eddiemoroz/Automated-9MM-Brass-Headstamp-Sorting-System/ESP32 Code/Arduino IDE Settings.txt

Version 2.3.7

BOARDS MANAGER: INSTALL esp32

Tools->
-
Board: "ESP32S3 Dev Module"
-
USB CDC On Boot: "Enabled"
CPU Frequency: "240MHz (Wifi)"
Core Debug Level: "None"
USB DFU On Boot: "Diabled"
Erase All Flash Before Sketch Upload: "Enabled"
Events Run On: "Core 1"
Flash Mode: "QIO 80MHz"
Flash Size: "4MB (32Mb)"
JTAG Adapter: "Disabled"
Arduino Runs On: "Core 1"
USB Firmware MSC On Boot: "Disabled"
Partition Scheme: "Default 4MB with spiffs (1.2MB APP/1.5MB SPIFFS)"
PSRAM: "Disabled"
Upload Mode: "UART0/Hardware CDC"
Upload Speed: "921600"
USB Mode: "Hardware CDC and JTAG"
Zigbee Mode: "Disabled"
-
Programmer: "Esptool"
