eddiemoroz/Automated-9MM-Brass-Headstamp-Sorting-System/Enclosure/Bins/Bin Base R.stl

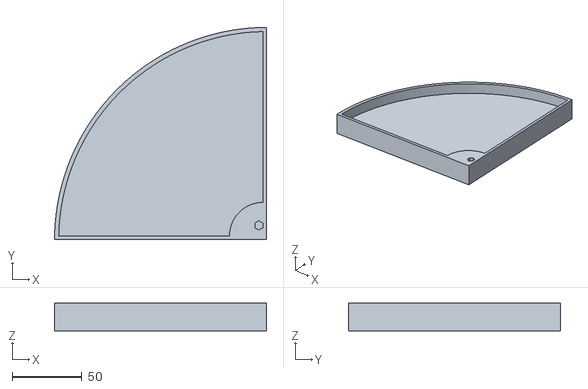
[picture p1: CAD file, 2026-05-16]
Enclosure/Bins/Bin Base R.stl
151.9 x 152.1 x 20.0
