eddiemoroz/Automated-9MM-Brass-Headstamp-Sorting-System/Enclosure/Camera/Camera Mount Column.stl

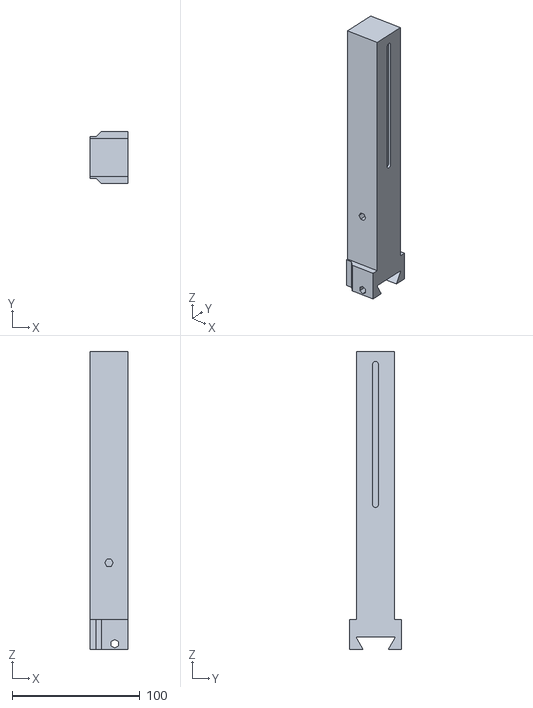
[picture p2: CAD file, 2026-05-16]
Enclosure/Camera/Camera Mount Column.stl
30.0 x 40.8 x 233.6
