eddiemoroz/Automated-9MM-Brass-Headstamp-Sorting-System/Enclosure/Display/Display Mount.stl

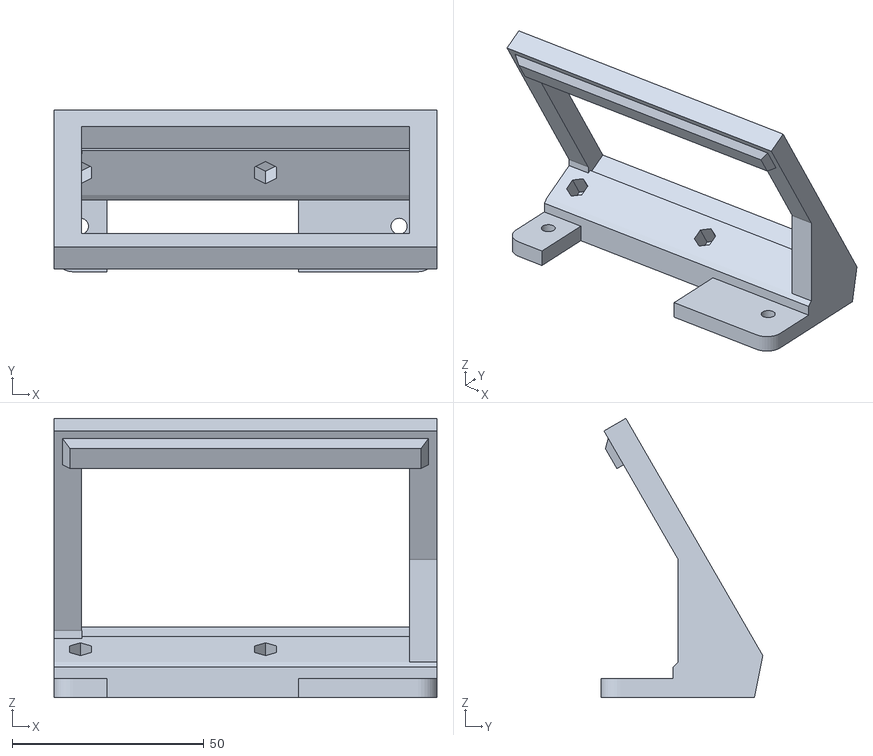
[picture p3: CAD file, 2026-05-16]
Enclosure/Display/Display Mount.stl
100.0 x 42.2 x 72.9
