eddiemoroz/Automated-9MM-Brass-Headstamp-Sorting-System/Enclosure/Feeding Tube/Feeding Tube Adjustment.stl

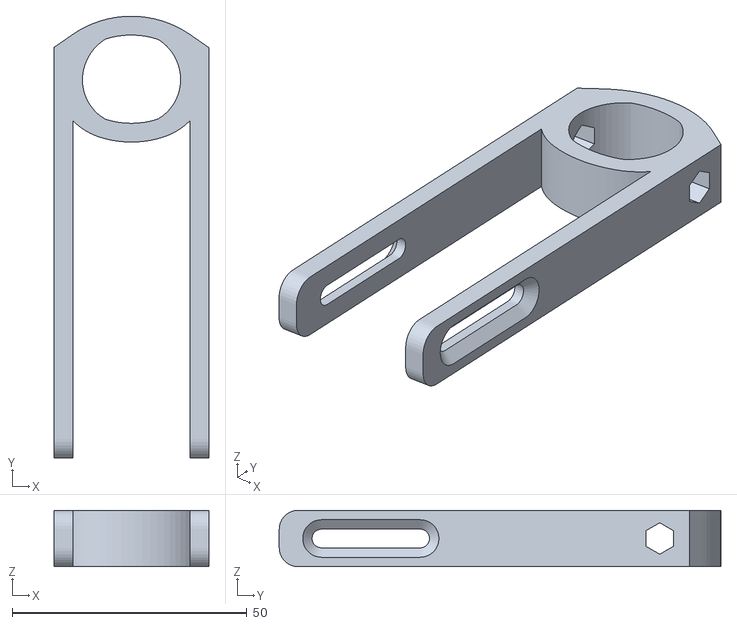
[picture p4: CAD file, 2026-05-16]
Enclosure/Feeding Tube/Feeding Tube Adjustment.stl
33.0 x 94.0 x 12.0
