eddiemoroz/Automated-9MM-Brass-Headstamp-Sorting-System/Enclosure/Frame/Camera Pillar.stl

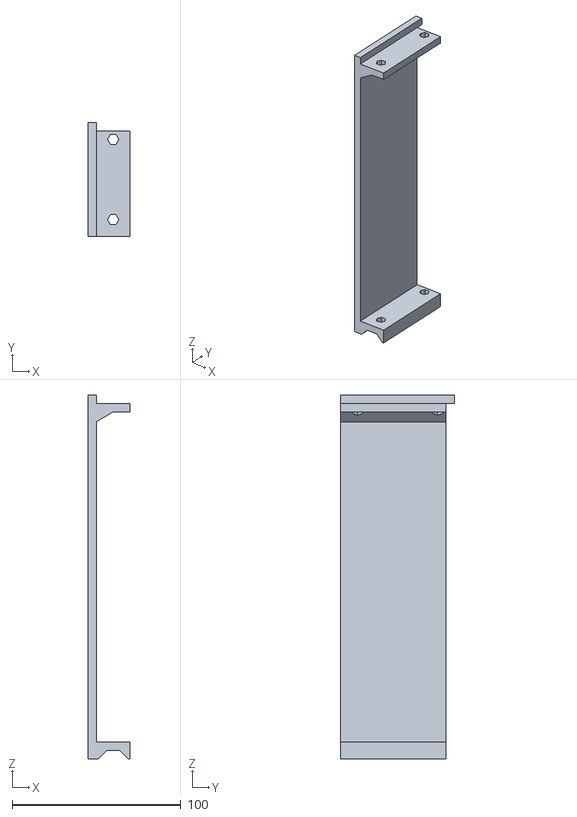
[picture p5: CAD file, 2026-05-16]
Enclosure/Frame/Camera Pillar.stl
25.0 x 67.6 x 215.9
