eddiemoroz/Automated-9MM-Brass-Headstamp-Sorting-System/Enclosure/Frame/Floor Supports/Floor Support L.stl

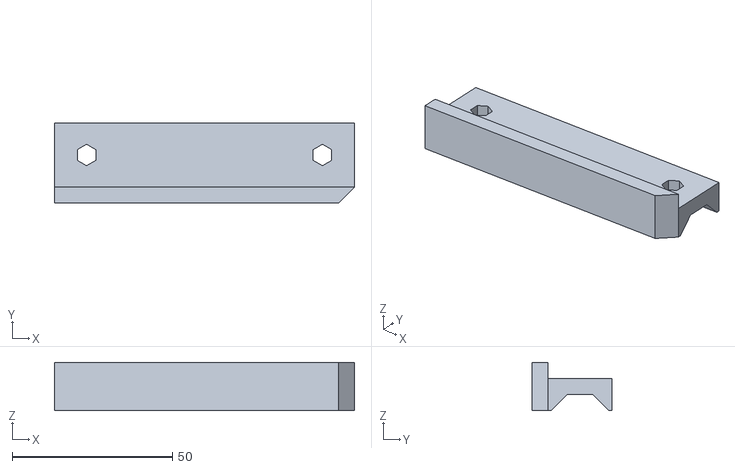
[picture p6: CAD file, 2026-05-16]
Enclosure/Frame/Floor Supports/Floor Support L.stl
93.6 x 25.0 x 15.0
