eddiemoroz/Automated-9MM-Brass-Headstamp-Sorting-System/Enclosure/Shroud/Shroud L.stl

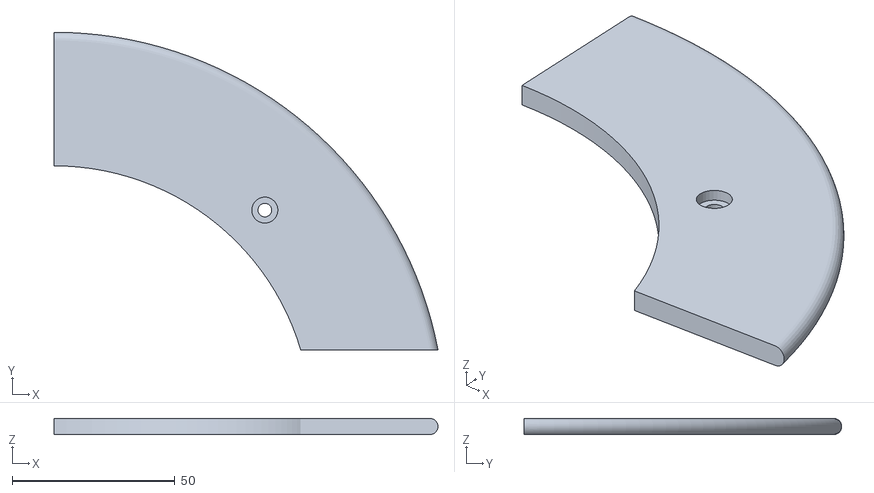
[picture p7: CAD file, 2026-05-16]
Enclosure/Shroud/Shroud L.stl
117.9 x 97.5 x 5.00
