eddiemoroz/Automated-9MM-Brass-Headstamp-Sorting-System/Enclosure/Sorter.stl

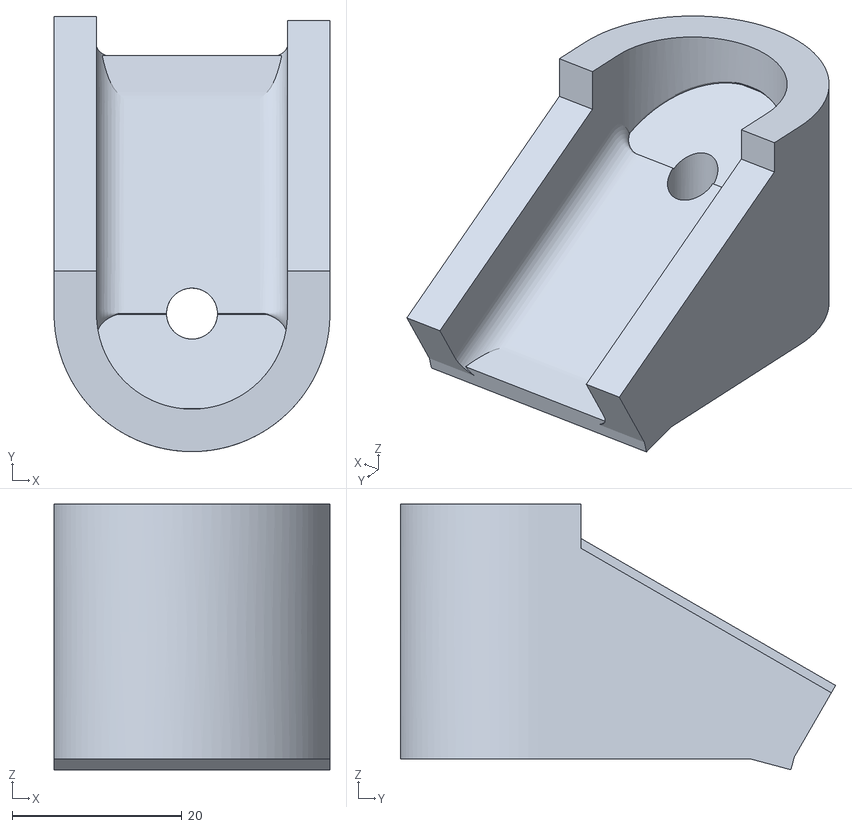
[picture p8: CAD file, 2026-05-16]
Enclosure/Sorter.stl
32.5 x 51.2 x 31.3
