eddiemoroz/Automated-9MM-Brass-Headstamp-Sorting-System/Enclosure/Bins/Bin1.stl

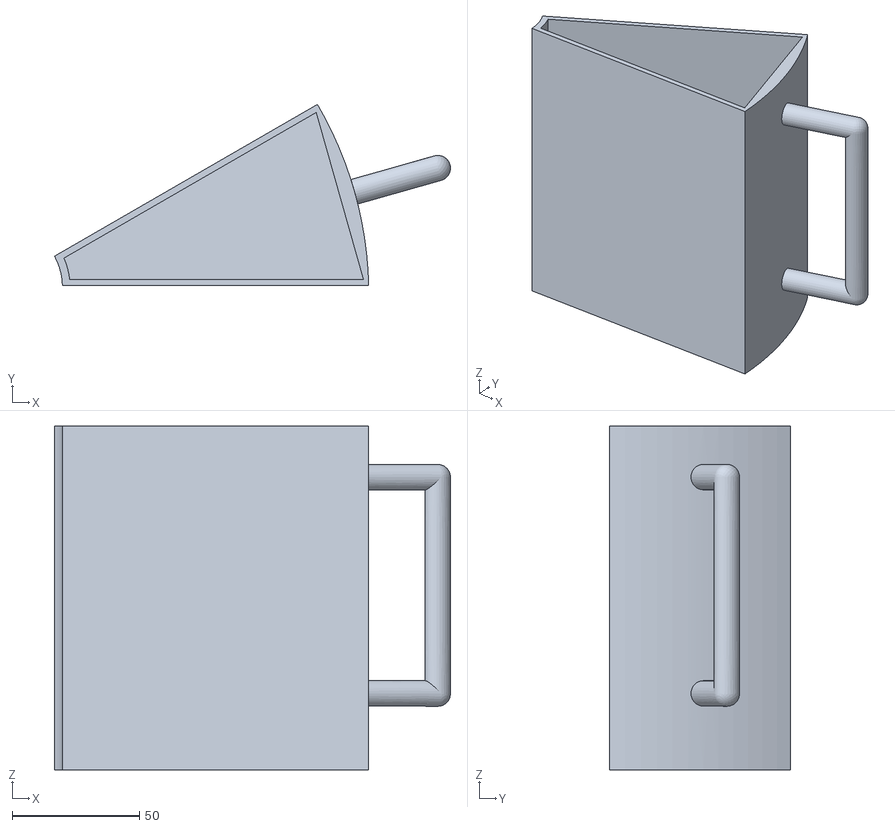
[picture p9: CAD file, 2026-05-16]
Enclosure/Bins/Bin1.stl
155.6 x 71.2 x 135.0
