eddiemoroz/Automated-9MM-Brass-Headstamp-Sorting-System/Enclosure/Camera/Camera Mount Base.stl

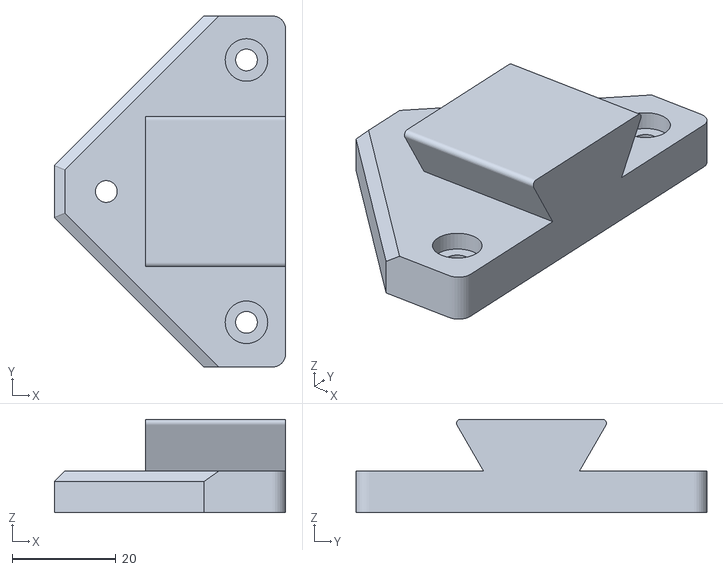
[picture p10: CAD file, 2026-05-16]
Enclosure/Camera/Camera Mount Base.stl
44.5 x 67.6 x 18.0
