eddiemoroz/Automated-9MM-Brass-Headstamp-Sorting-System/Enclosure/Display/Display Mount Clamp.stl

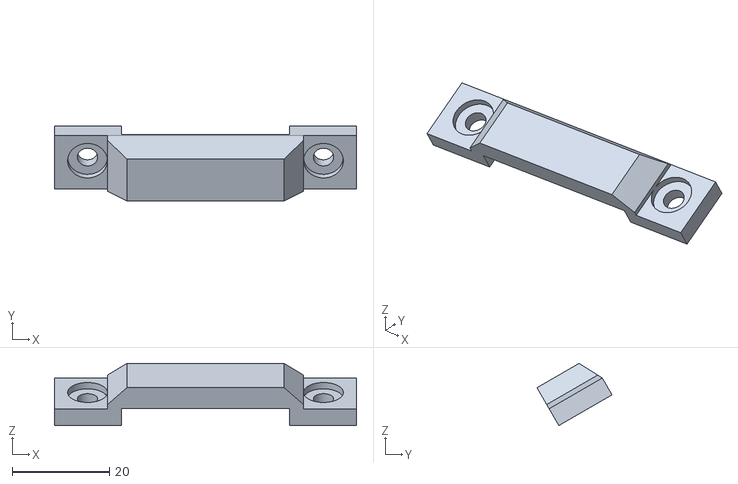
[picture p11: CAD file, 2026-05-16]
Enclosure/Display/Display Mount Clamp.stl
62.2 x 15.5 x 12.8
