eddiemoroz/Automated-9MM-Brass-Headstamp-Sorting-System/Enclosure/Feeding Tube/Feeding Tube Base.stl

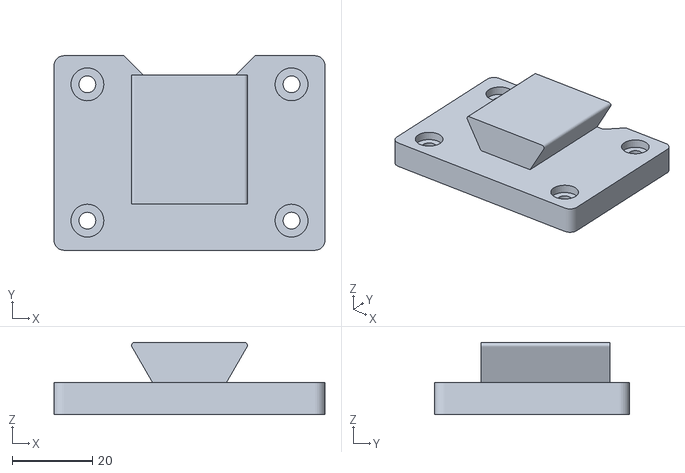
[picture p12: CAD file, 2026-05-16]
Enclosure/Feeding Tube/Feeding Tube Base.stl
67.6 x 48.5 x 18.0
