eddiemoroz/Automated-9MM-Brass-Headstamp-Sorting-System/Enclosure/Frame/Floor Supports/Floor Support M.stl

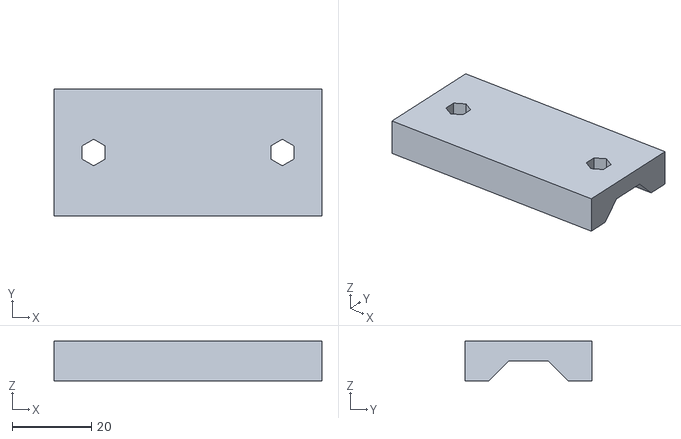
[picture p13: CAD file, 2026-05-16]
Enclosure/Frame/Floor Supports/Floor Support M.stl
67.6 x 32.0 x 10.00
