eddiemoroz/Automated-9MM-Brass-Headstamp-Sorting-System/Enclosure/Frame/Rear Pillar.stl

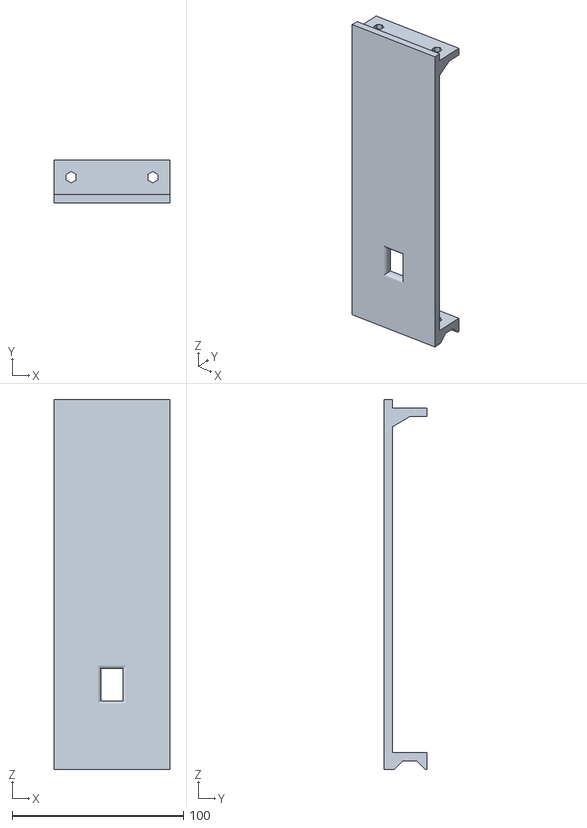
[picture p14: CAD file, 2026-05-16]
Enclosure/Frame/Rear Pillar.stl
67.6 x 25.0 x 215.9
