eddiemoroz/Automated-9MM-Brass-Headstamp-Sorting-System/Enclosure/Revolver.stl

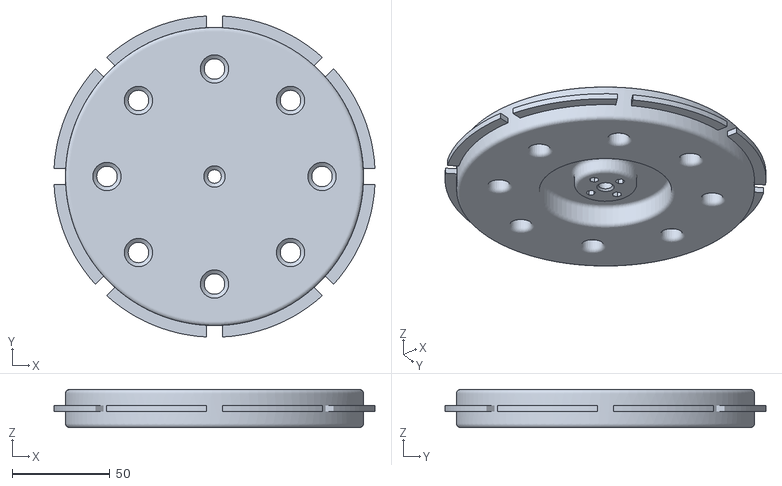
[picture p15: CAD file, 2026-05-16]
Enclosure/Revolver.stl
164.2 x 164.2 x 19.5
