eddiemoroz/Automated-9MM-Brass-Headstamp-Sorting-System/Enclosure/Camera/Camera Holder.stl

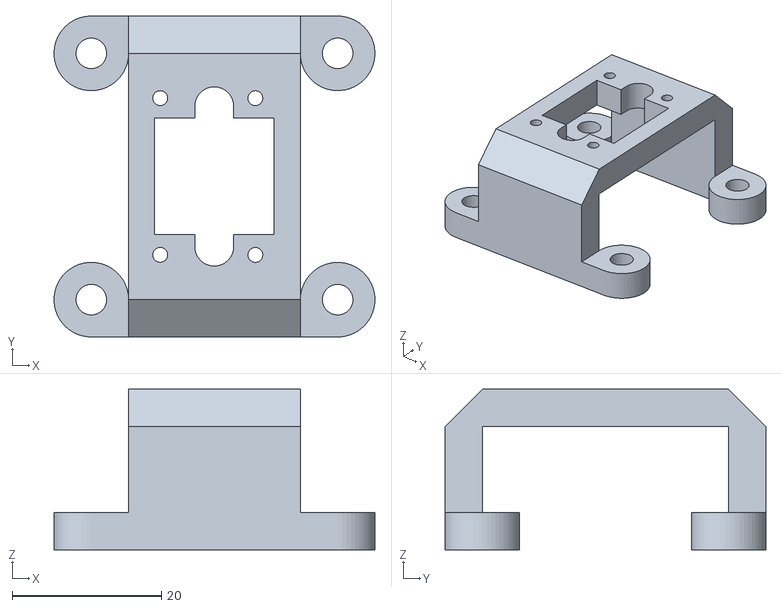
[picture p16: CAD file, 2026-05-16]
Enclosure/Camera/Camera Holder.stl
43.0 x 43.0 x 21.5
