eddiemoroz/Automated-9MM-Brass-Headstamp-Sorting-System/Enclosure/Display/Display Base.stl

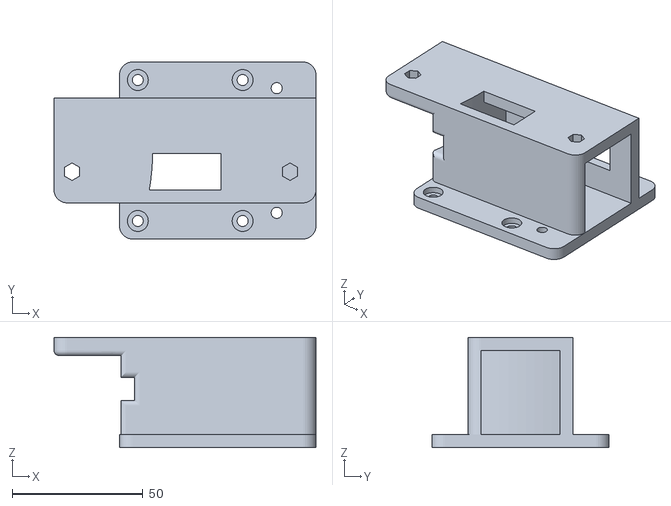
[picture p17: CAD file, 2026-05-16]
Enclosure/Display/Display Base.stl
100.0 x 67.6 x 42.1
