eddiemoroz/Automated-9MM-Brass-Headstamp-Sorting-System/Enclosure/Feeding Tube/Feed Tube Column.stl

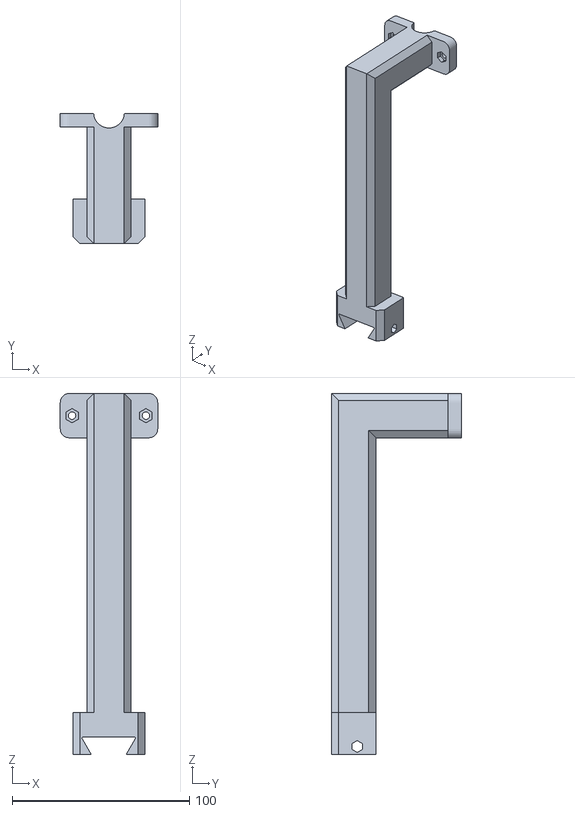
[picture p18: CAD file, 2026-05-16]
Enclosure/Feeding Tube/Feed Tube Column.stl
55.0 x 73.3 x 203.6
