eddiemoroz/Automated-9MM-Brass-Headstamp-Sorting-System/Enclosure/Frame/Floor Supports/Floor Support Ext R.stl

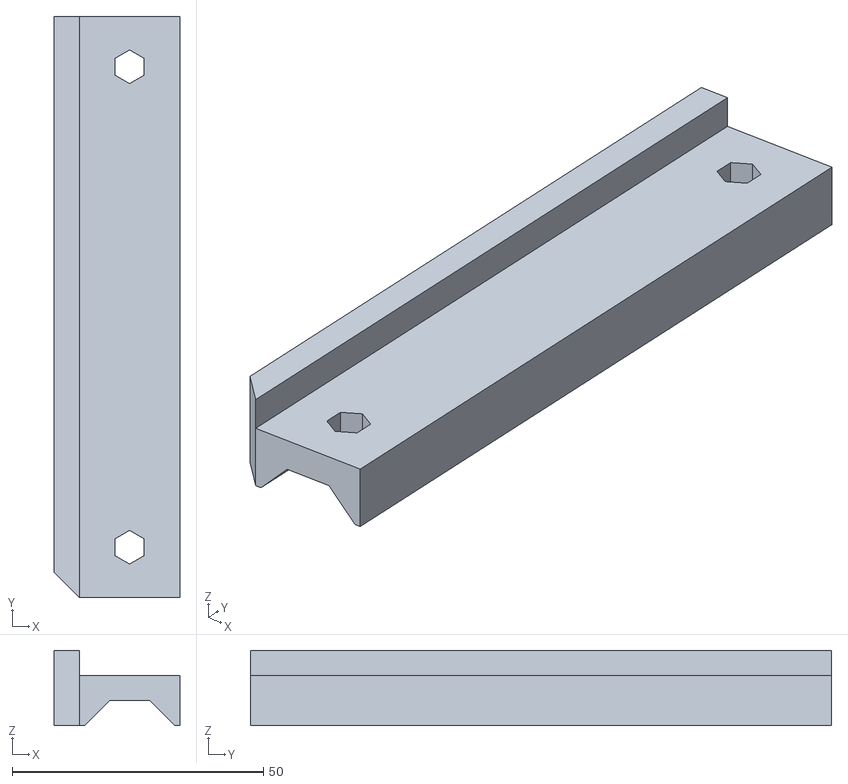
[picture p19: CAD file, 2026-05-16]
Enclosure/Frame/Floor Supports/Floor Support Ext R.stl
25.0 x 115.6 x 15.0
