eddiemoroz/Automated-9MM-Brass-Headstamp-Sorting-System/Enclosure/Frame/Servo Mount.stl

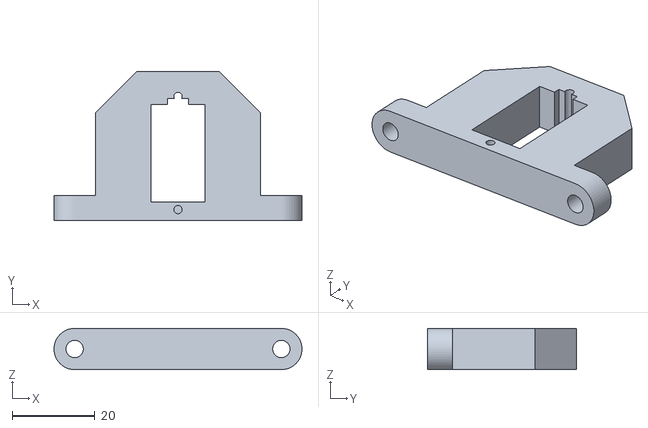
[picture p20: CAD file, 2026-05-16]
Enclosure/Frame/Servo Mount.stl
60.0 x 36.0 x 10.0
