eddiemoroz/Automated-9MM-Brass-Headstamp-Sorting-System/Enclosure/Photo Sensor Mount.stl

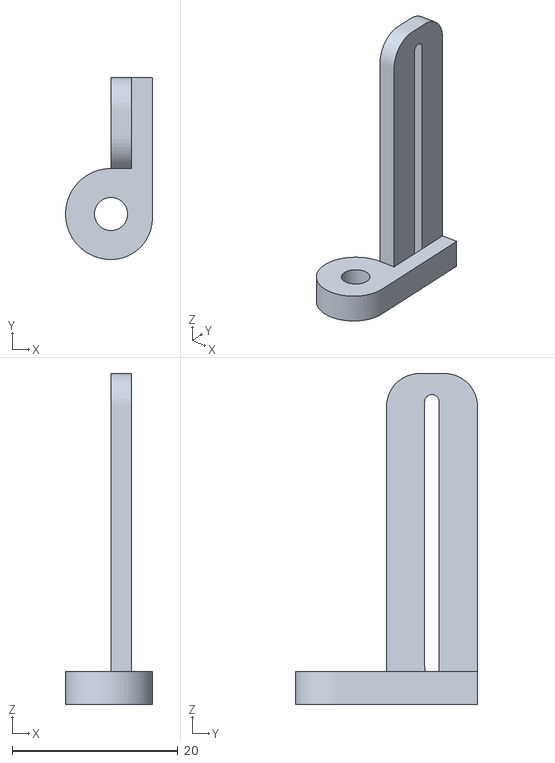
[picture p21: CAD file, 2026-05-16]
Enclosure/Photo Sensor Mount.stl
10.5 x 22.0 x 40.0
