eddiemoroz/Automated-9MM-Brass-Headstamp-Sorting-System/Enclosure/Shroud/Shroud connector.stl

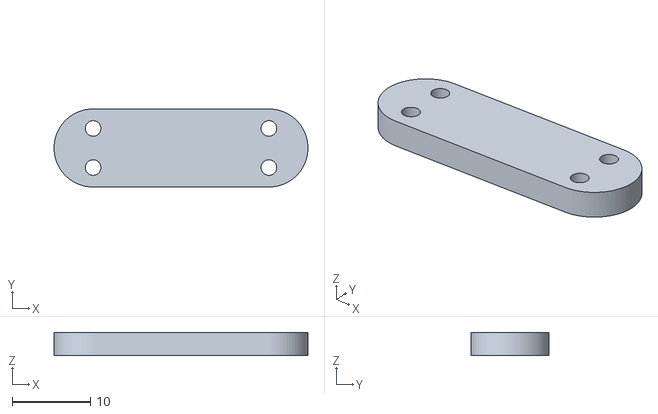
[picture p22: CAD file, 2026-05-16]
Enclosure/Shroud/Shroud connector.stl
32.5 x 10.0 x 3.00
