eddiemoroz/Automated-9MM-Brass-Headstamp-Sorting-System/Enclosure/Bins/Chicken Clamp.stl

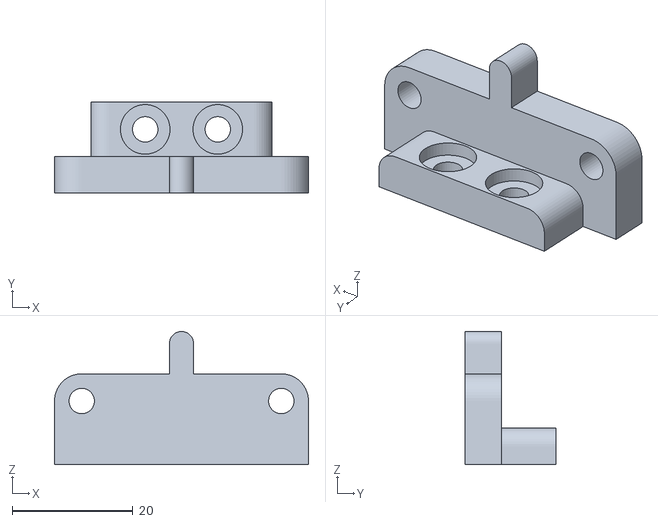
[picture p23: CAD file, 2026-05-16]
Enclosure/Bins/Chicken Clamp.stl
42.0 x 15.0 x 22.0
