eddiemoroz/Automated-9MM-Brass-Headstamp-Sorting-System/Enclosure/Camera/Bottom Funnel.stl

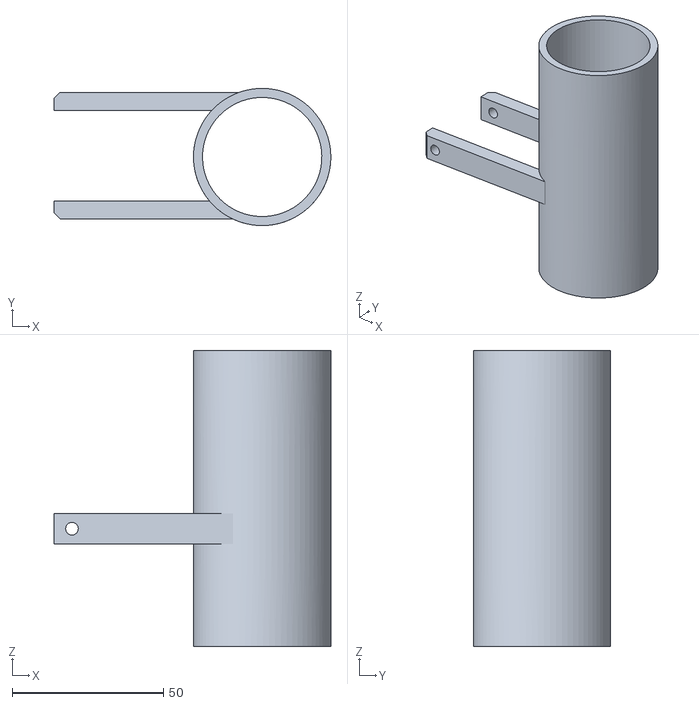
[picture p24: CAD file, 2026-05-16]
Enclosure/Camera/Bottom Funnel.stl
91.6 x 45.4 x 98.0
