eddiemoroz/Automated-9MM-Brass-Headstamp-Sorting-System/Enclosure/Feeding Tube/Feeding Tube Clamp.stl

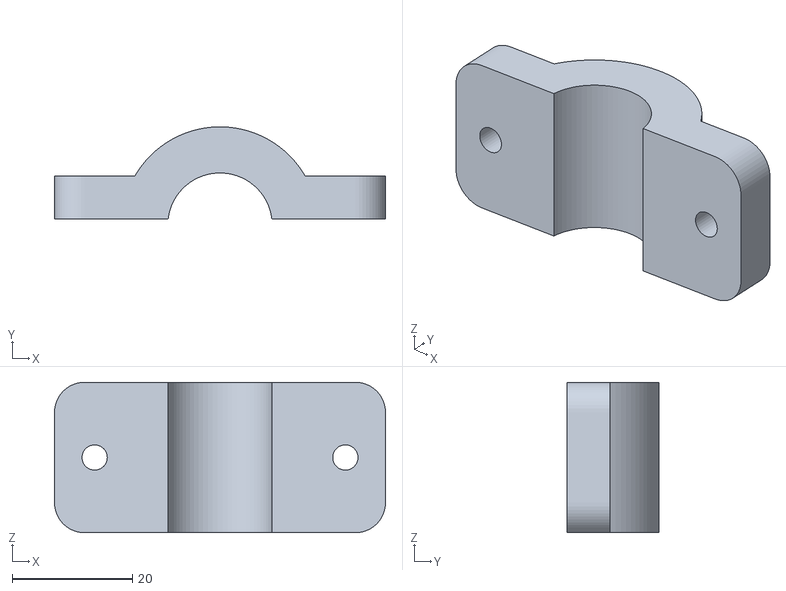
[picture p25: CAD file, 2026-05-16]
Enclosure/Feeding Tube/Feeding Tube Clamp.stl
55.0 x 15.3 x 25.0
