eddiemoroz/Automated-9MM-Brass-Headstamp-Sorting-System/Enclosure/Frame/Front Pillar.stl

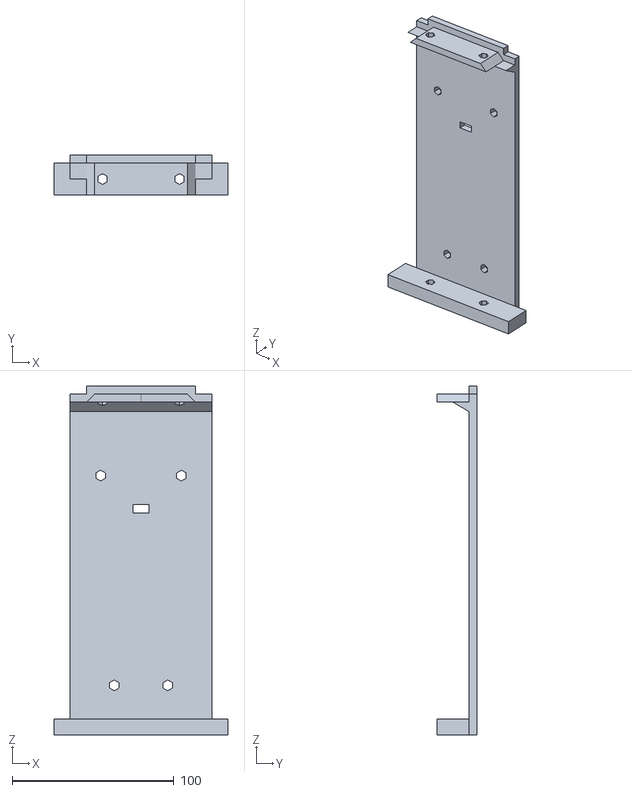
[picture p26: CAD file, 2026-05-16]
Enclosure/Frame/Front Pillar.stl
107.6 x 25.0 x 215.9
