eddiemoroz/Automated-9MM-Brass-Headstamp-Sorting-System/Enclosure/PCB Standoffs.stl

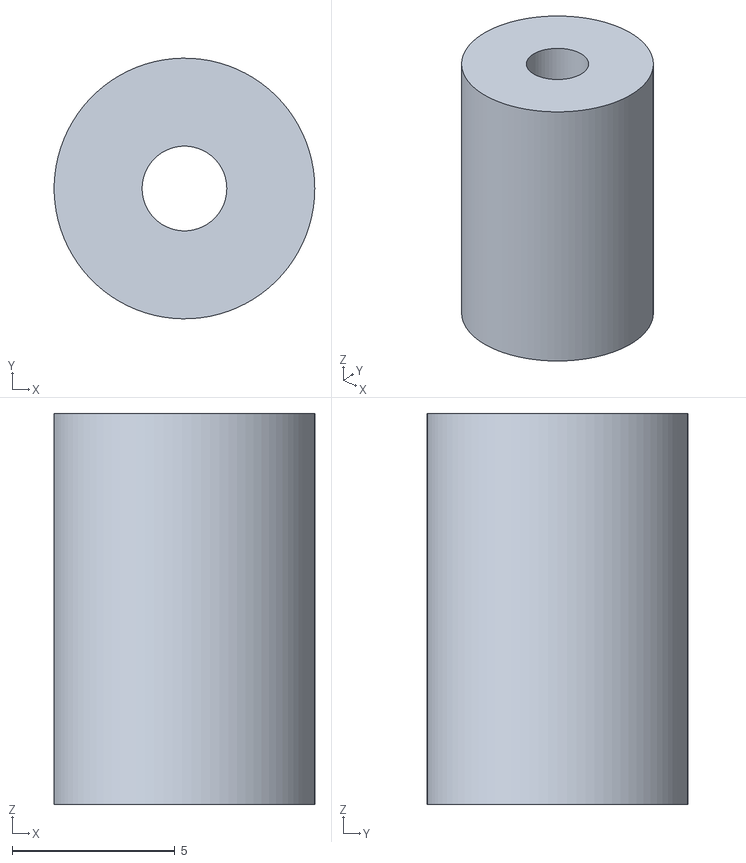
[picture p27: CAD file, 2026-05-16]
Enclosure/PCB Standoffs.stl
8.00 x 8.00 x 12.0
