eddiemoroz/Automated-9MM-Brass-Headstamp-Sorting-System/Enclosure/Shroud/Shroud Base.stl

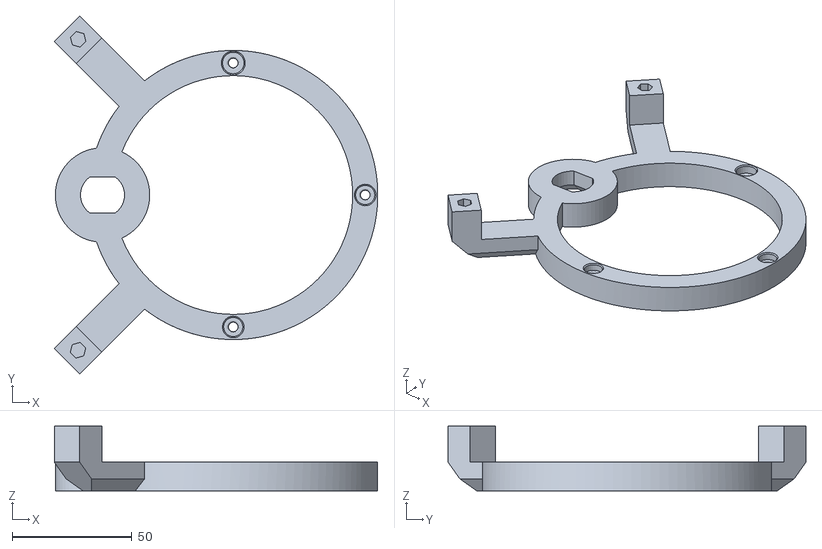
[picture p28: CAD file, 2026-05-16]
Enclosure/Shroud/Shroud Base.stl
134.8 x 149.2 x 27.0
