eddiemoroz/Automated-9MM-Brass-Headstamp-Sorting-System/Enclosure/Camera/Ring Light.stl

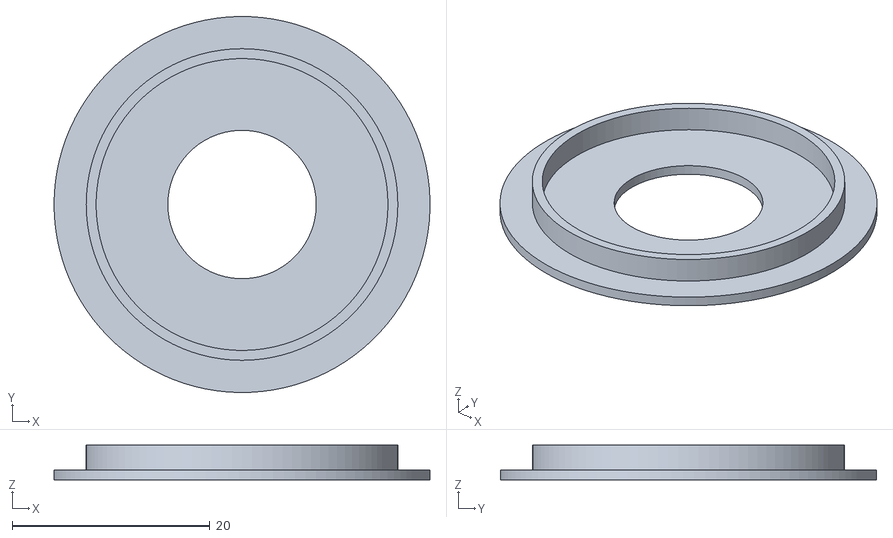
[picture p29: CAD file, 2026-05-16]
Enclosure/Camera/Ring Light.stl
38.0 x 38.0 x 3.50
