eddiemoroz/Automated-9MM-Brass-Headstamp-Sorting-System/Enclosure/Feeding Tube/Feeding Tube.stl

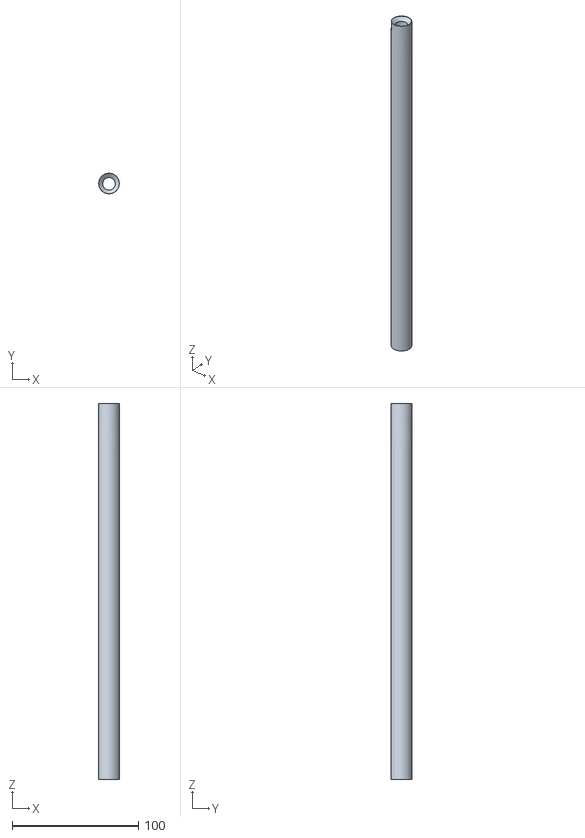
[picture p30: CAD file, 2026-05-16]
Enclosure/Feeding Tube/Feeding Tube.stl
16.3 x 16.4 x 298.0
