eddiemoroz/Automated-9MM-Brass-Headstamp-Sorting-System/Enclosure/Frame/Camera Face.stl

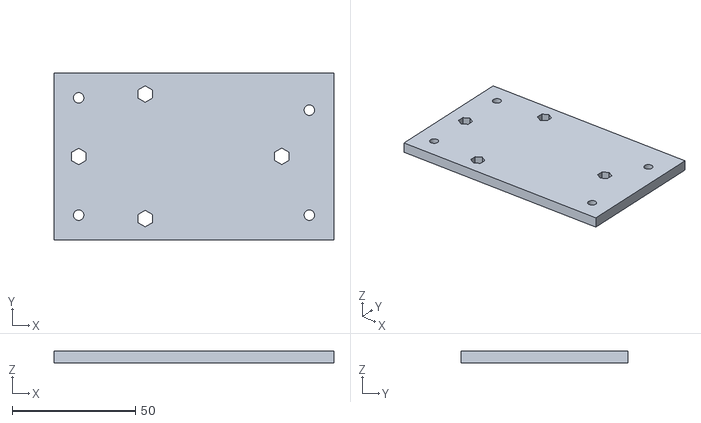
[picture p31: CAD file, 2026-05-16]
Enclosure/Frame/Camera Face.stl
113.6 x 67.6 x 5.00
