eddiemoroz/Automated-9MM-Brass-Headstamp-Sorting-System/Enclosure/Camera/Top Funnel.stl

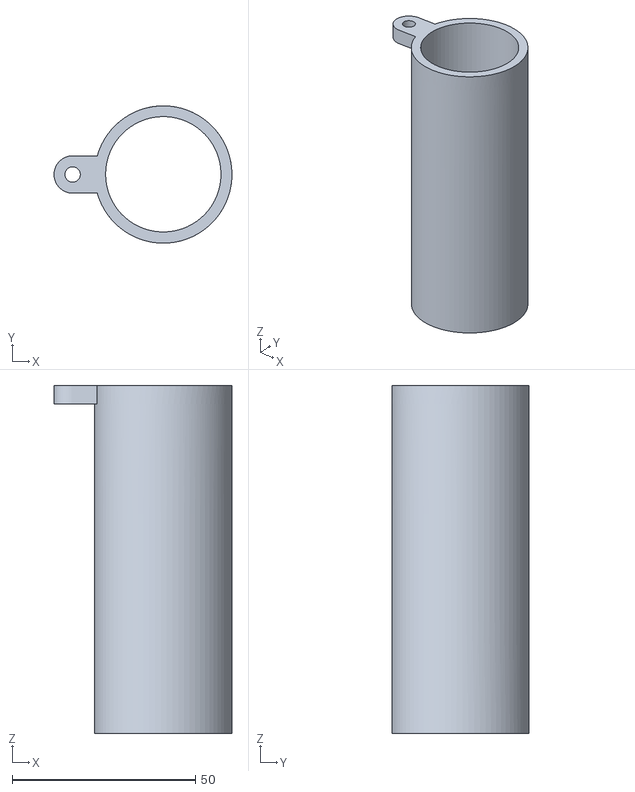
[picture p32: CAD file, 2026-05-16]
Enclosure/Camera/Top Funnel.stl
48.6 x 37.5 x 95.0
