eddiemoroz/Automated-9MM-Brass-Headstamp-Sorting-System/Enclosure/Frame/Bottom Panel R.stl

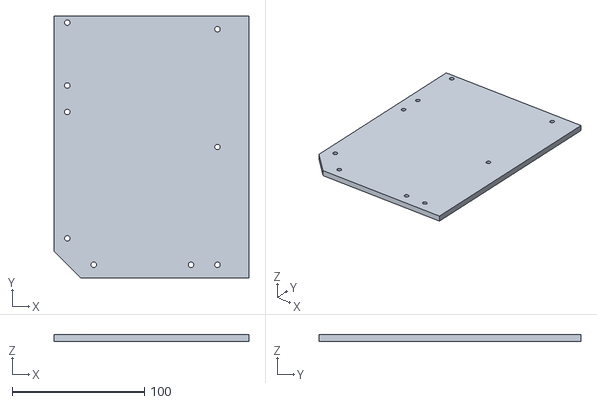
[picture p33: CAD file, 2026-05-16]
Enclosure/Frame/Bottom Panel R.stl
147.4 x 198.2 x 5.00
