eddiemoroz/Automated-9MM-Brass-Headstamp-Sorting-System/Enclosure/Camera/Camera Mount.stl

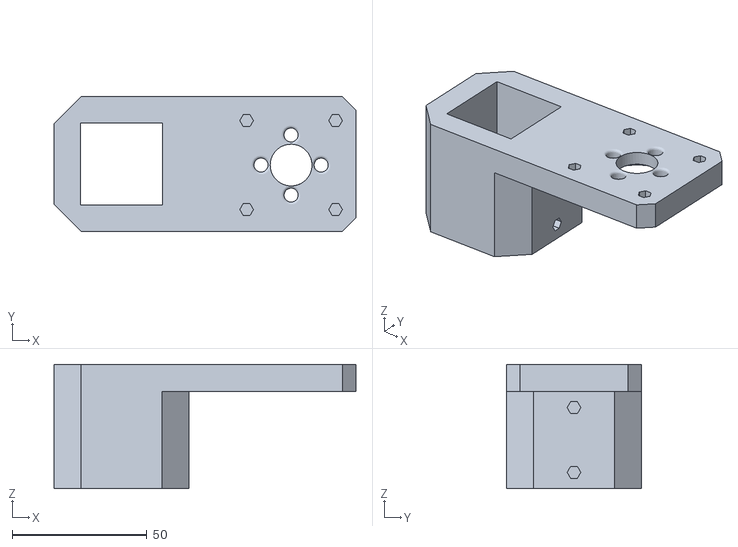
[picture p34: CAD file, 2026-05-16]
Enclosure/Camera/Camera Mount.stl
112.0 x 50.0 x 46.0
