eddiemoroz/Automated-9MM-Brass-Headstamp-Sorting-System/Enclosure/Frame/Top Face.stl

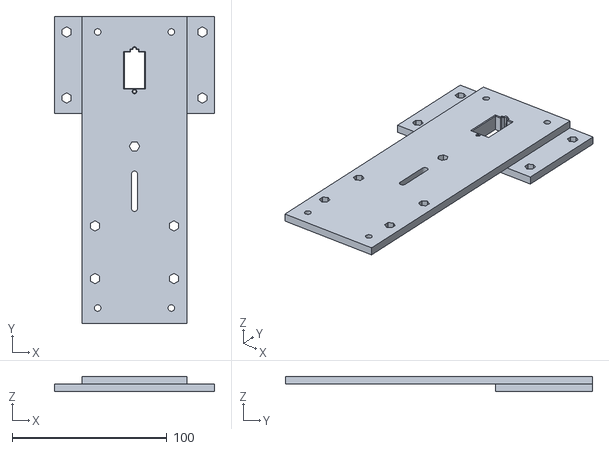
[picture p35: CAD file, 2026-05-16]
Enclosure/Frame/Top Face.stl
103.6 x 198.2 x 10.0
