eddiemoroz/Automated-9MM-Brass-Headstamp-Sorting-System/Enclosure/Frame/Bottom Panel L.stl

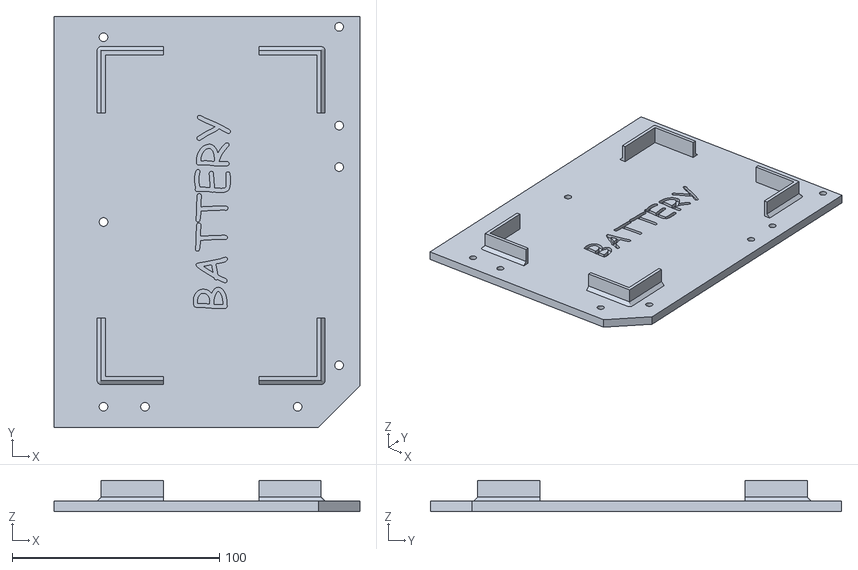
[picture p36: CAD file, 2026-05-16]
Enclosure/Frame/Bottom Panel L.stl
147.4 x 198.2 x 15.0
