eddiemoroz/Automated-9MM-Brass-Headstamp-Sorting-System/Enclosure/Frame/Left Panel.stl

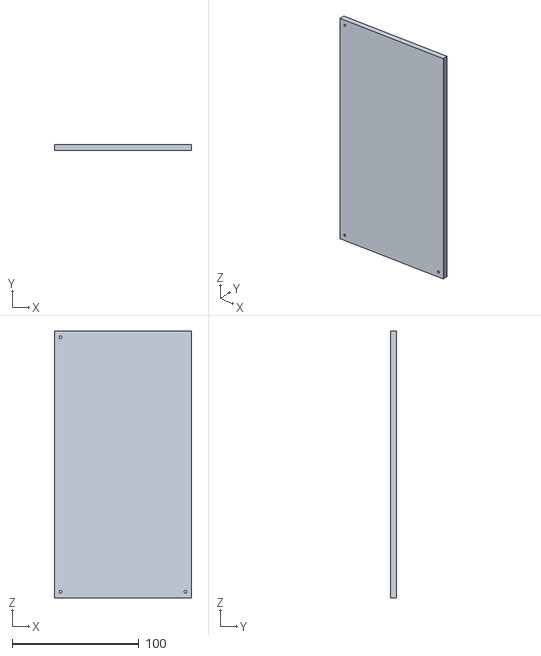
[picture p37: CAD file, 2026-05-16]
Enclosure/Frame/Left Panel.stl
108.6 x 5.00 x 210.9
