eddiemoroz/Automated-9MM-Brass-Headstamp-Sorting-System/(list of files, cad)

Other CAD files:
Enclosure/Shroud/Shroud R.stl
Enclosure/Bins/Bin Base L.stl
Enclosure/Frame/Floor Supports/Floor Support R.stl
Enclosure/Frame/Floor Supports/Floor Support Ext L.stl
Enclosure/Frame/Display Pillar.stl
Enclosure/Frame/Display Face.stl
Enclosure/Frame/Right Panel.stl
Enclosure/Enclosure.f3z
