eddiemoroz/Automated-9MM-Brass-Headstamp-Sorting-System/PCB Files/System PCB-Controls Mk.2/System PCB-Controls Mk.2.kicad_pcb

## KiCad design PCB Files/System PCB-Controls Mk.2/System PCB-Controls Mk.2.kicad_pcb (2026-05-16)

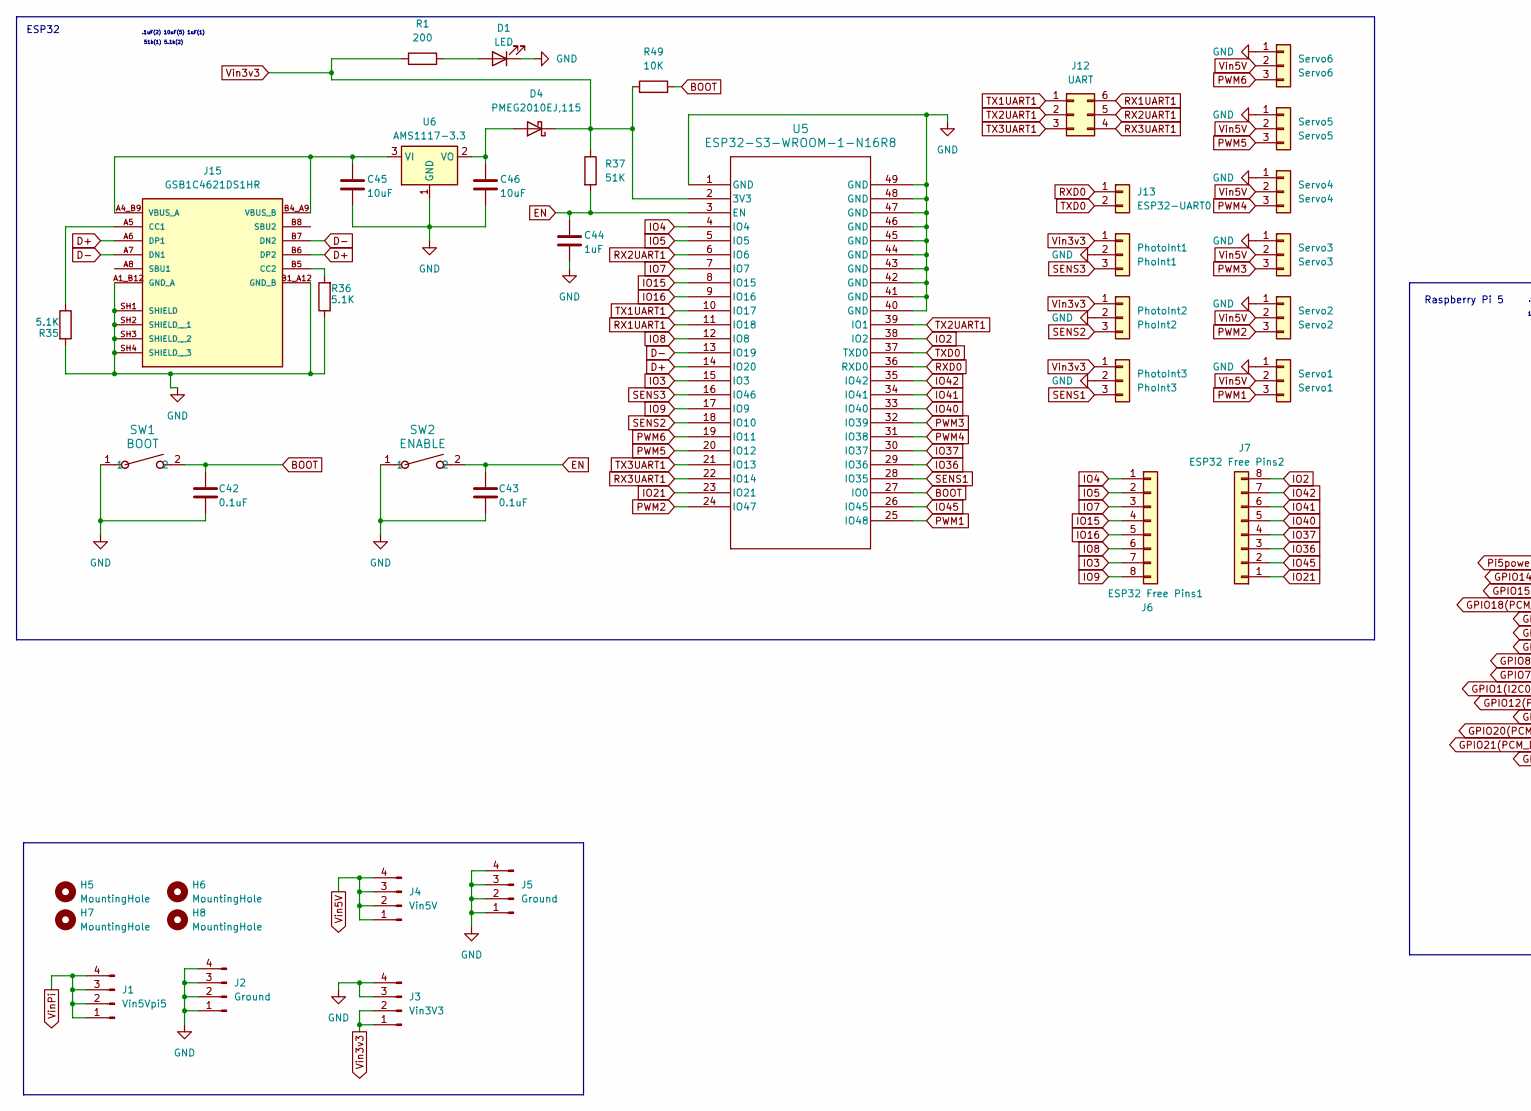
[picture p38: schematic System PCB-Controls Mk.2.kicad_sch, part in row 1, column 1]

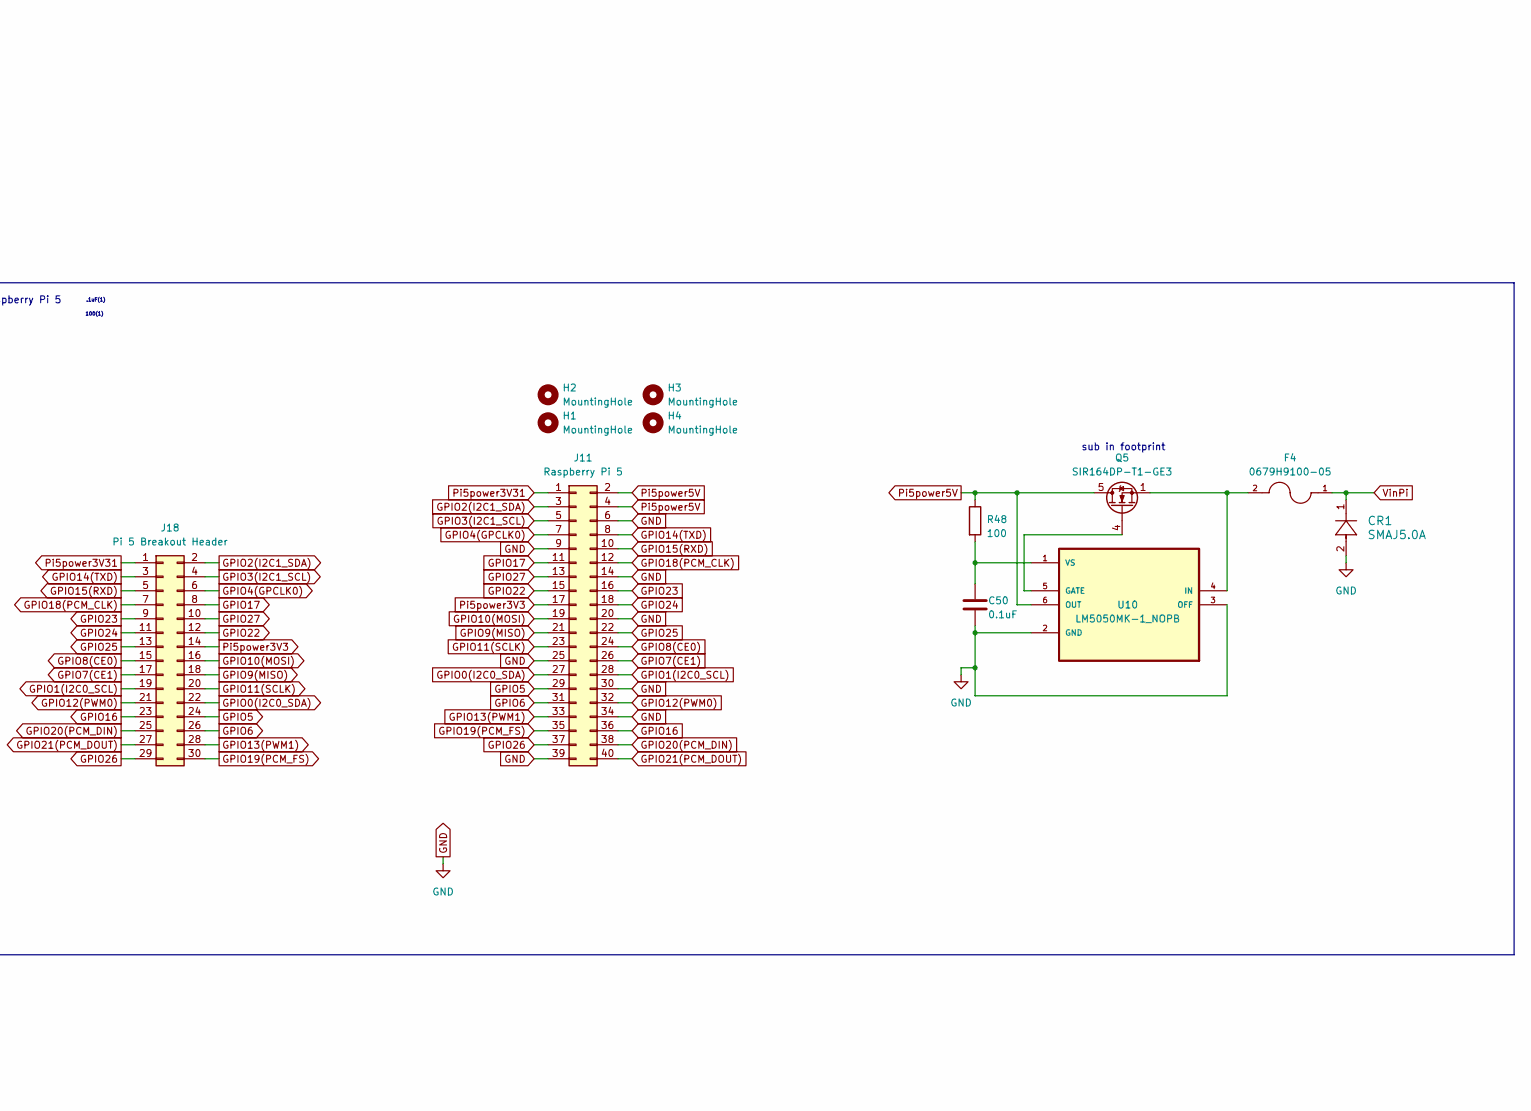
[picture p39: schematic System PCB-Controls Mk.2.kicad_sch, part in row 1, column 2]

Parts:
C42, C43, C50: 0.1uF; C_0805_2012Metric_Pad1.18x1.45mm_HandSolder
C44: 1uF; C_0603_1608Metric_Pad1.08x0.95mm_HandSolder
C45, C46: 10uF; C_1206_3216Metric_Pad1.33x1.80mm_HandSolder
CR1: SMAJ5.0A; SMA5.0A
D1: LED; R_1206_3216Metric_Pad1.30x1.75mm_HandSolder
D4: PMEG2010EJ,115; D_SOD-323F
F4: 0679H9100-05; FUSC6125X279N; PARTREV 0679H Apr2019
H1, H2, H3, H4: MountingHole; MountingHole_2.7mm_M2.5
H5, H6, H7, H8: MountingHole; MountingHole_3.2mm_M3
J1: Vin5Vpi5; FanPinHeader_1x04_P2.54mm_Vertical
J2, J5: Ground; FanPinHeader_1x04_P2.54mm_Vertical
J3: Vin3V3; FanPinHeader_1x04_P2.54mm_Vertical
J4: Vin5V; FanPinHeader_1x04_P2.54mm_Vertical
J6: ESP32 Free Pins1; PinSocket_1x08_P2.54mm_Vertical
J7: ESP32 Free Pins2; PinSocket_1x08_P2.54mm_Vertical
J11: Raspberry Pi 5; PinSocket_2x20_P2.54mm_Vertical
J12: UART; PinSocket_2x03_P2.54mm_Vertical
J13: ESP32-UART0; PinSocket_1x02_P2.54mm_Vertical
J15: GSB1C4621DS1HR; AMPHENOL_GSB1C4621DS1HR; PARTREV AX1
J18: Pi 5 Breakout Header; PinHeader_2x15_P2.54mm_Vertical
PhotoInt1: PhoInt1; FanPinHeader_1x03_P2.54mm_Vertical
PhotoInt2: PhoInt2; FanPinHeader_1x03_P2.54mm_Vertical
PhotoInt3: PhoInt3; FanPinHeader_1x03_P2.54mm_Vertical
Q5: SIR164DP-T1-GE3; PowerPAK_SO-8_Single
R1: 200; R_1206_3216Metric_Pad1.30x1.75mm_HandSolder
R35, R36: 5.1K; R_1206_3216Metric_Pad1.30x1.75mm_HandSolder
R37: 51K; R_1206_3216Metric_Pad1.30x1.75mm_HandSolder
R48: 100; R_1206_3216Metric_Pad1.30x1.75mm_HandSolder
R49: 10K; R_1206_3216Metric_Pad1.30x1.75mm_HandSolder
SW1: BOOT; SW_PTS636_CNK
SW2: ENABLE; SW_PTS636_CNK
Servo1: Servo1; PinSocket_1x03_P2.54mm_Vertical
Servo2: Servo2; PinSocket_1x03_P2.54mm_Vertical
Servo3: Servo3; PinSocket_1x03_P2.54mm_Vertical
Servo4: Servo4; PinSocket_1x03_P2.54mm_Vertical
Servo5: Servo5; PinSocket_1x03_P2.54mm_Vertical
Servo6: Servo6; PinSocket_1x03_P2.54mm_Vertical
U5: ESP32-S3-WROOM-1-N16R8; ESP32-S3-WROOM-1_EXP
U6: AMS1117-3.3; SOT-223-3_TabPin2
U10: LM5050MK-1_NOPB; LM5050MK-1NOPB

Connections:
BOOT: C42.1, R49.2, SW1.2, U5.27 (IO0)
D+: J15.A6 (DP1), J15.B6 (DP2), U5.14 (IO20)
D-: J15.A7 (DN1), J15.B7 (DN2), U5.13 (IO19)
EN: C43.1, C44.1, R37.2, SW2.2, U5.3 (EN)
GND: C42.2, C43.2, C44.2, C45.2, C46.2, C50.2, CR1.2, D1.1 (K), J2.1, J2.2, J2.3, J2.4, J3.3, J3.4, J5.1, J5.2, J5.3, J5.4, J11.6, J11.9, J11.14, J11.20, J11.25, J11.30, J11.34, J11.39, J15.A1_B12 (GND_A), J15.B1_A12 (GND_B), J15.SH1 (SHIELD), J15.SH2 (SHIELD__1), J15.SH3 (SHIELD__2), J15.SH4 (SHIELD__3), PhotoInt1.2, PhotoInt2.2, PhotoInt3.2, R35.2, R36.1, SW1.1, SW2.1, Servo1.1, Servo2.1, Servo3.1, Servo4.1, Servo5.1, Servo6.1, U5.1 (GND), U5.40 (GND), U5.41 (GND), U5.42 (GND), U5.43 (GND), U5.44 (GND), U5.45 (GND), U5.46 (GND), U5.47 (GND), U5.48 (GND), U5.49 (GND), U6.1 (GND), U10.2 (GND), U10.3 (OFF)
GPIO0(I2C0_SDA): J11.27, J18.22
GPIO1(I2C0_SCL): J11.28, J18.19
GPIO2(I2C1_SDA): J11.3, J18.2
GPIO3(I2C1_SCL): J11.5, J18.4
GPIO4(GPCLK0): J11.7, J18.6
GPIO5: J11.29, J18.24
GPIO6: J11.31, J18.26
GPIO7(CE1): J11.26, J18.17
GPIO8(CE0): J11.24, J18.15
GPIO9(MISO): J11.21, J18.18
GPIO10(MOSI): J11.19, J18.16
GPIO11(SCLK): J11.23, J18.20
GPIO12(PWM0): J11.32, J18.21
GPIO13(PWM1): J11.33, J18.28
GPIO14(TXD): J11.8, J18.3
GPIO15(RXD): J11.10, J18.5
GPIO16: J11.36, J18.23
GPIO17: J11.11, J18.8
GPIO18(PCM_CLK): J11.12, J18.7
GPIO19(PCM_FS): J11.35, J18.30
GPIO20(PCM_DIN): J11.38, J18.25
GPIO21(PCM_DOUT): J11.40, J18.27
GPIO22: J11.15, J18.12
GPIO23: J11.16, J18.9
GPIO24: J11.18, J18.11
GPIO25: J11.22, J18.13
GPIO26: J11.37, J18.29
GPIO27: J11.13, J18.10
IO2: J7.8, U5.38 (IO2)
IO3: J6.7, U5.15 (IO3)
IO4: J6.1, U5.4 (IO4)
IO5: J6.2, U5.5 (IO5)
IO7: J6.3, U5.7 (IO7)
IO8: J6.6, U5.12 (IO8)
IO9: J6.8, U5.17 (IO9)
IO15: J6.4, U5.8 (IO15)
IO16: J6.5, U5.9 (IO16)
IO21: J7.1, U5.23 (IO21)
IO36: J7.3, U5.29 (IO36)
IO37: J7.4, U5.30 (IO37)
IO40: J7.5, U5.33 (IO40)
IO41: J7.6, U5.34 (IO41)
IO42: J7.7, U5.35 (IO42)
IO45: J7.2, U5.26 (IO45)
unnamed: D1.2 (A), R1.2
unnamed: C46.1, D4.2 (A), U6.2 (VO)
unnamed: J15.A5 (CC1), R35.1
unnamed: J15.B5 (CC2), R36.2
unnamed: C45.1, J15.A4_B9 (VBUS_A), J15.B4_A9 (VBUS_B), U6.3 (VI)
unnamed: Q5.4 (G), U10.5 (GATE)
unnamed: F4.2, Q5.1 (S), Q5.2 (S), Q5.3 (S), U10.4 (IN)
unnamed: C50.1, R48.2, U10.1 (VS)
PWM1: Servo1.3, U5.25 (IO48)
PWM2: Servo2.3, U5.24 (IO47)
PWM3: Servo3.3, U5.32 (IO39)
PWM4: Servo4.3, U5.31 (IO38)
PWM5: Servo5.3, U5.20 (IO12)
PWM6: Servo6.3, U5.19 (IO11)
Pi5power3V3: J11.17, J18.14
Pi5power3V31: J11.1, J18.1
Pi5power5V: J11.2, J11.4, Q5.5 (D), R48.1, U10.6 (OUT)
RX1UART1: J12.6, U5.11 (IO18)
RX2UART1: J12.5, U5.6 (IO6)
RX3UART1: J12.4, U5.22 (IO14)
RXD0: J13.1, U5.36 (RXD0)
SENS1: PhotoInt3.3, U5.28 (IO35)
SENS2: PhotoInt2.3, U5.18 (IO10)
SENS3: PhotoInt1.3, U5.16 (IO46)
TX1UART1: J12.1, U5.10 (IO17)
TX2UART1: J12.2, U5.39 (IO1)
TX3UART1: J12.3, U5.21 (IO13)
TXD0: J13.2, U5.37 (TXD0)
Vin3v3: D4.1 (K), J3.1, J3.2, PhotoInt1.1, PhotoInt2.1, PhotoInt3.1, R1.1, R37.1, R49.1, U5.2 (3V3)
Vin5V: J4.1, J4.2, J4.3, J4.4, Servo1.2, Servo2.2, Servo3.2, Servo4.2, Servo5.2, Servo6.2
VinPi: CR1.1, F4.1, J1.1, J1.2, J1.3, J1.4

Notes on the sheet:
sub in footprint
.1uF(2) 10uF(5) 1uF(1)
.1uF(1)
ESP32
100(1)
Raspberry Pi 5
51k(1) 5.1k(2)

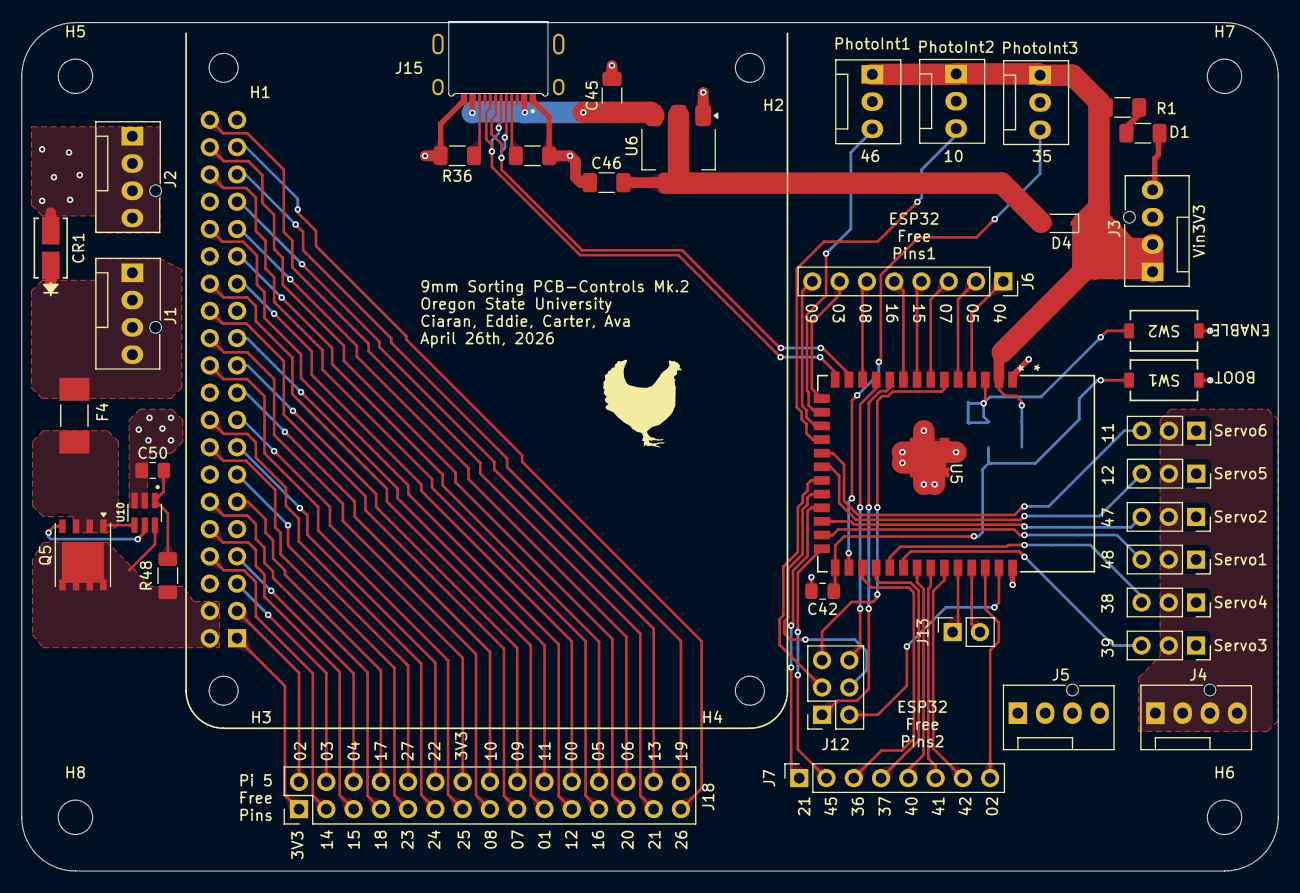
[picture p40: board System PCB-Controls Mk.2.kicad_pcb from above]

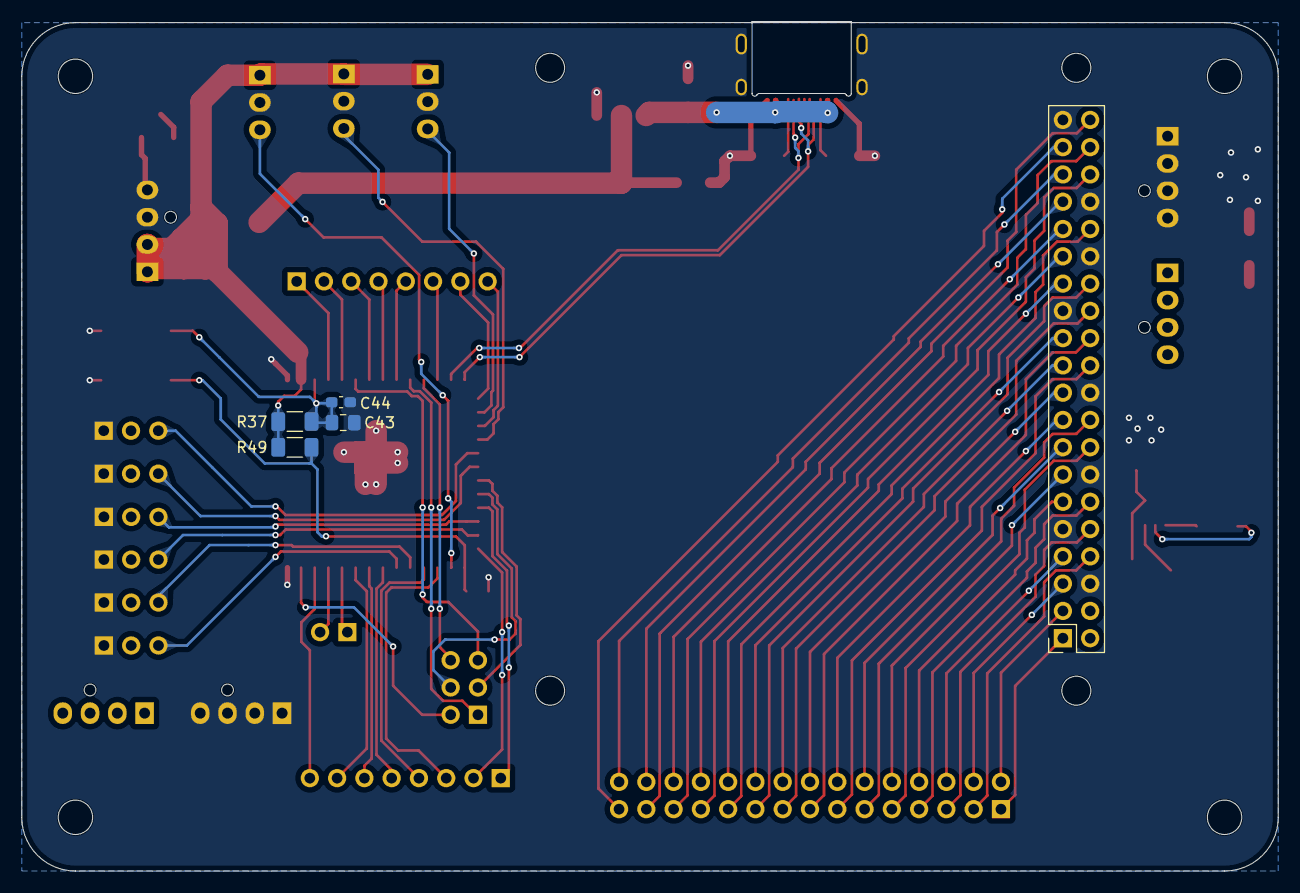
[picture p41: board System PCB-Controls Mk.2.kicad_pcb from below]

Board: 2 copper layers, 117.0 x 79.0 mm, 51 parts (5 on the bottom side), 80 nets.
