eddiemoroz/Automated-9MM-Brass-Headstamp-Sorting-System/PCB Files/System PCB-Charging Mk.2/System PCB-Charging Mk.2.kicad_pcb

## KiCad design PCB Files/System PCB-Charging Mk.2/System PCB-Charging Mk.2.kicad_pcb (2026-05-16)

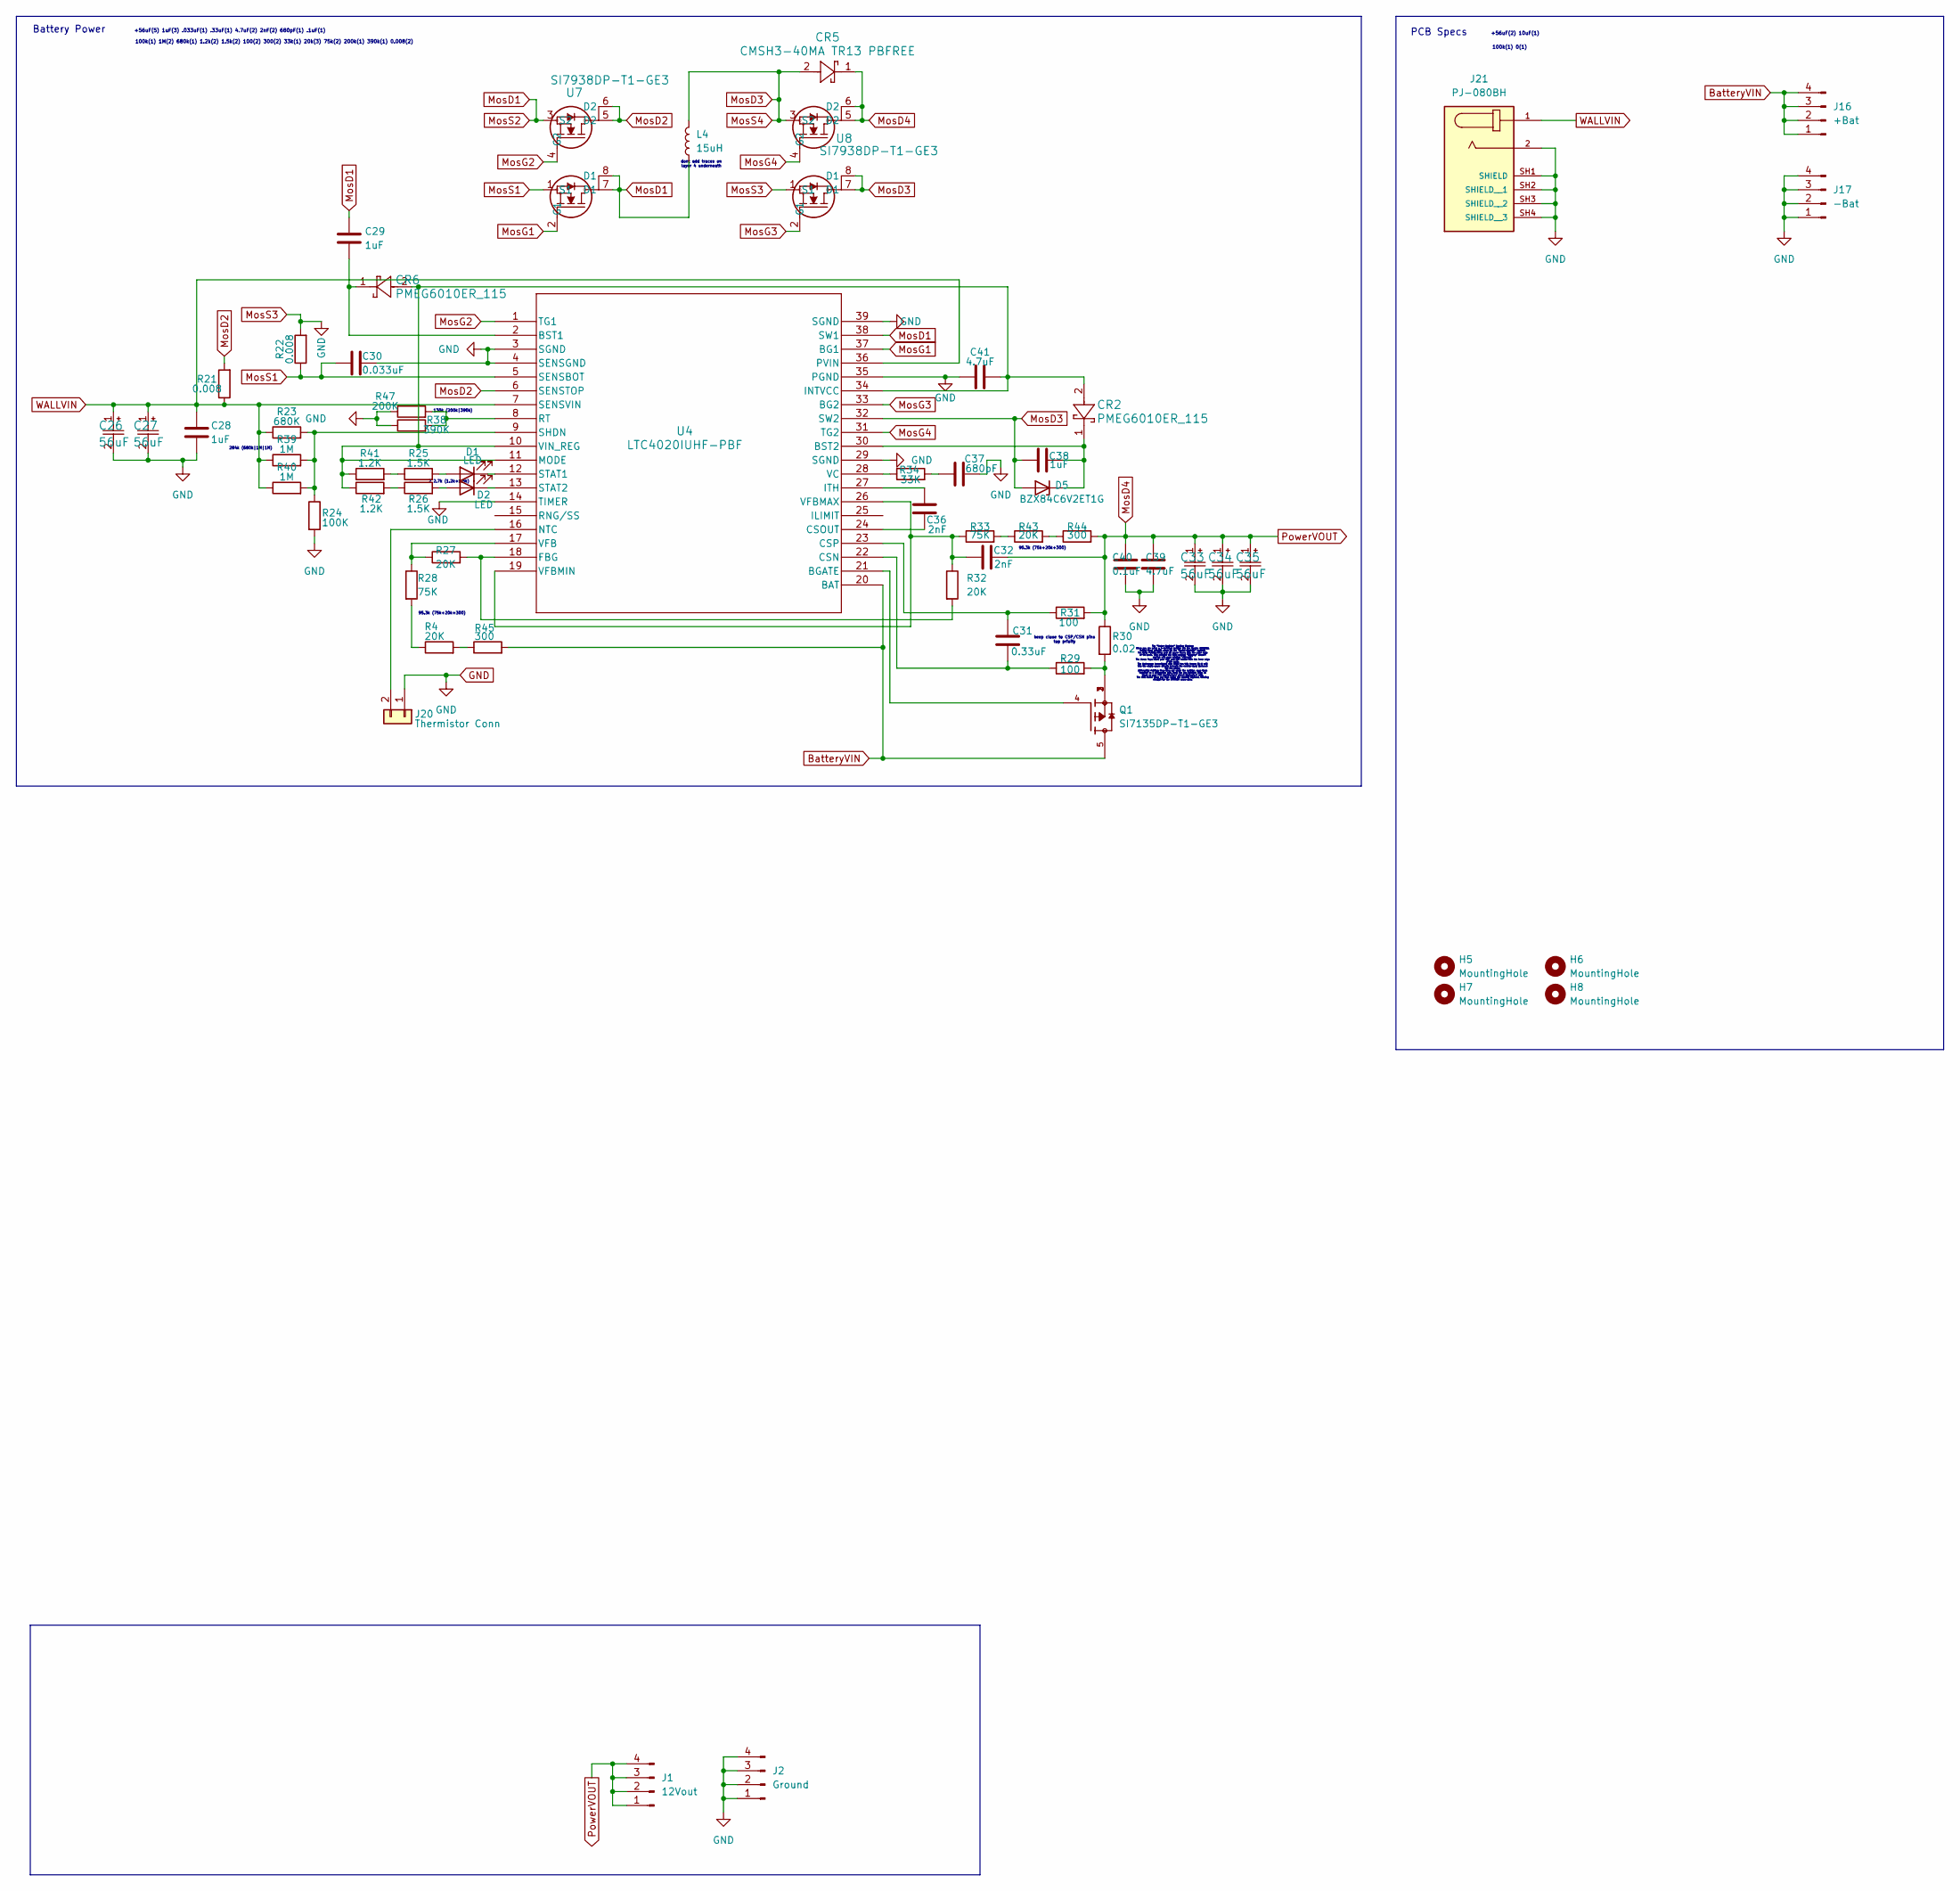
[picture p42: schematic System PCB-Charging Mk.2.kicad_sch]

Parts:
C26, C27, C33, C34, C35: 56uF; CAP_GY_6P3X5P8_NCH-M
C28, C29, C38: 1uF; C_0603_1608Metric_Pad1.08x0.95mm_HandSolder
C30: 0.033uF; C_0805_2012Metric_Pad1.18x1.45mm_HandSolder
C31: 0.33uF; C_0805_2012Metric_Pad1.18x1.45mm_HandSolder
C32, C36: 2nF; C_0805_2012Metric_Pad1.18x1.45mm_HandSolder
C37: 680pF; C_0603_1608Metric_Pad1.08x0.95mm_HandSolder
C39, C41: 4.7uF; C_1206_3216Metric_Pad1.33x1.80mm_HandSolder
C40: 0.1uF; C_0805_2012Metric_Pad1.18x1.45mm_HandSolder
CR2, CR6: PMEG6010ER_115; Nexperia_CFP3_SOD-123W
CR5: CMSH3-40MA TR13 PBFREE; CR_SMA-CMSH3-40MA_CNS-M
D1, D2: LED; LED_0201_0603Metric_Pad0.64x0.40mm_HandSolder
D5: BZX84C6V2ET1G; SOT-23_Handsoldering
H5, H6, H7, H8: MountingHole; MountingHole_3.2mm_M3
J1: 12Vout; FanPinHeader_1x04_P2.54mm_Vertical
J2: Ground; FanPinHeader_1x04_P2.54mm_Vertical
J16: +Bat; FanPinHeader_1x04_P2.54mm_Vertical
J17: -Bat; FanPinHeader_1x04_P2.54mm_Vertical
J20: Thermistor Conn; PinSocket_1x02_P2.54mm_Vertical
J21: PJ-080BH; CUI_PJ-080BH; PARTREV 1.04
L4: 15uH; IND_SRP1265A-150M
Q1: SI7135DP-T1-GE3; TRANS_SI7135DP-T1-GE3; PARTREV A
R4, R27, R32, R43: 20K; R_1206_3216Metric_Pad1.30x1.75mm_HandSolder
R21, R22: 0.008; R_2512_6332Metric_Pad1.40x3.35mm_HandSolder
R23: 680K; R_1206_3216Metric_Pad1.30x1.75mm_HandSolder
R24: 100K; R_1206_3216Metric_Pad1.30x1.75mm_HandSolder
R25, R26: 1.5K; R_1206_3216Metric_Pad1.30x1.75mm_HandSolder
R28, R33: 75K; R_1206_3216Metric_Pad1.30x1.75mm_HandSolder
R29, R31: 100; R_1206_3216Metric_Pad1.30x1.75mm_HandSolder
R30: 0.02; R_2512_6332Metric_Pad1.40x3.35mm_HandSolder
R34: 33K; R_1206_3216Metric_Pad1.30x1.75mm_HandSolder
R38: 390K; R_1206_3216Metric_Pad1.30x1.75mm_HandSolder
R39, R40: 1M; R_1206_3216Metric_Pad1.30x1.75mm_HandSolder
R41, R42: 1.2K; R_1206_3216Metric_Pad1.30x1.75mm_HandSolder
R44, R45: 300; R_1206_3216Metric_Pad1.30x1.75mm_HandSolder
R47: 200K; R_1206_3216Metric_Pad1.30x1.75mm_HandSolder
U4: LTC4020IUHF-PBF; LTC4020IUHF#PBF
U7, U8: SI7938DP-T1-GE3; PowerPAK_DP-T1-GE3_VIS

Connections:
BatteryVIN: J16.1, J16.2, J16.3, J16.4, Q1.5, R45.2, U4.20 (BAT)
GND: C26.2, C27.2, C28.2, C30.1, C33.2, C34.2, C35.2, C37.2, C39.2, C40.2, C41.1, J2.1, J2.2, J2.3, J2.4, J17.1, J17.2, J17.3, J17.4, J20.1, J21.2, J21.SH1 (SHIELD), J21.SH2 (SHIELD__1), J21.SH3 (SHIELD__2), J21.SH4 (SHIELD__3), R22.2, R24.2, R38.1, R47.1, U4.3 (SGND), U4.4 (SENSGND), U4.14 (TIMER), U4.29 (SGND), U4.35 (PGND), U4.39 (SGND), U8.1 (S1)
MosD1: C29.1, L4.1, U4.38 (SW1), U7.3 (S2), U7.7 (D1), U7.8 (D1)
MosD2: R21.2, U4.6 (SENSTOP), U7.5 (D2), U7.6 (D2)
MosD3: C38.1, CR5.2, D5.1 (A), L4.2, U4.32 (SW2), U8.3 (S2), U8.7 (D1), U8.8 (D1)
MosD4: C32.2, C33.1, C34.1, C35.1, C39.1, C40.1, CR5.1, J1.1, J1.2, J1.3, J1.4, R30.1, R31.2, R44.2, U8.5 (D2), U8.6 (D2)
MosG1: U4.37 (BG1), U7.2 (G1)
MosG2: U4.1 (TG1), U7.4 (G2)
MosG3: U4.33 (BG2), U8.2 (G1)
MosG4: U4.31 (TG2), U8.4 (G2)
MosS1: C30.2, R22.1, U4.5 (SENSBOT), U7.1 (S1)
unnamed: C37.1, R34.2
unnamed: D1.2 (A), R25.2
unnamed: D1.1 (K), U4.12 (STAT1)
unnamed: D2.2 (A), R26.2
unnamed: D2.1 (K), U4.13 (STAT2)
unnamed: C38.2, CR2.1, D5.3 (K), U4.30 (BST2)
unnamed: J20.2, U4.16 (NTC)
unnamed: Q1.1, Q1.2, Q1.3, R29.2, R30.2
unnamed: R4.2, R45.1
unnamed: R25.1, R41.2
unnamed: R26.1, R42.2
unnamed: R4.1, R28.2
unnamed: R33.2, R43.1
unnamed: R43.2, R44.1
unnamed: Q1.4, U4.21 (BGATE)
unnamed: C29.2, CR6.1, U4.2 (BST1)
unnamed: C31.2, R29.1, U4.22 (CSN)
unnamed: C36.2, U4.24 (CSOUT)
unnamed: C31.1, R31.1, U4.23 (CSP)
unnamed: R27.2, R32.2, U4.18 (FBG)
unnamed: C41.2, CR2.2, CR6.2, R41.1, R42.1, U4.10 (VIN_REG), U4.11 (MODE), U4.34 (INTVCC)
unnamed: C36.1, U4.27 (ITH)
unnamed: R38.2, R47.2, U4.8 (RT)
unnamed: R23.2, R24.1, R39.2, R40.2, U4.9 (SHDN)
unnamed: R34.1, U4.28 (VC)
unnamed: R27.1, R28.1, U4.17 (VFB)
unnamed: C32.1, R32.1, R33.1, U4.19 (VFBMIN), U4.26 (VFBMAX)
WALLVIN: C26.1, C27.1, C28.1, J21.1, R21.1, R23.1, R39.1, R40.1, U4.7 (SENSVIN), U4.36 (PVIN)

Notes on the sheet:
95.3k (75k+20k+300)
2 2.7k (1.2k+1.5k)
284k (680k|1M|1M)
+56uF(5) 1uF(3) .033uF(1) .33uF(1) 4.7uF(2) 2nF(2) 680pF(1) .1uF(1)
+56uF(2) 10uF(1)
PCB Specs
130k (200k|390k)
100k(1) 1M(2) 680k(1) 1.2k(2) 1.5k(2) 100(2) 300(2) 33k(1) 20k(3) 75k(2) 200k(1) 390k(1) 0.008(2)
keep close to CSP/CSN pins top prioity
dont add traces on layer 4 underneath
Battery Power
100k(1) 0(1)
The "Under-Resistor" Routing Strategy Since you are using a 2-terminal resistor like the Bourns CRA2512, follow these specific steps for the "Under-Resistor" method: The Entry Points: Bring your 8A power traces into the outer ends of the pads. This ensures the high-current "highway" doesn't overlap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

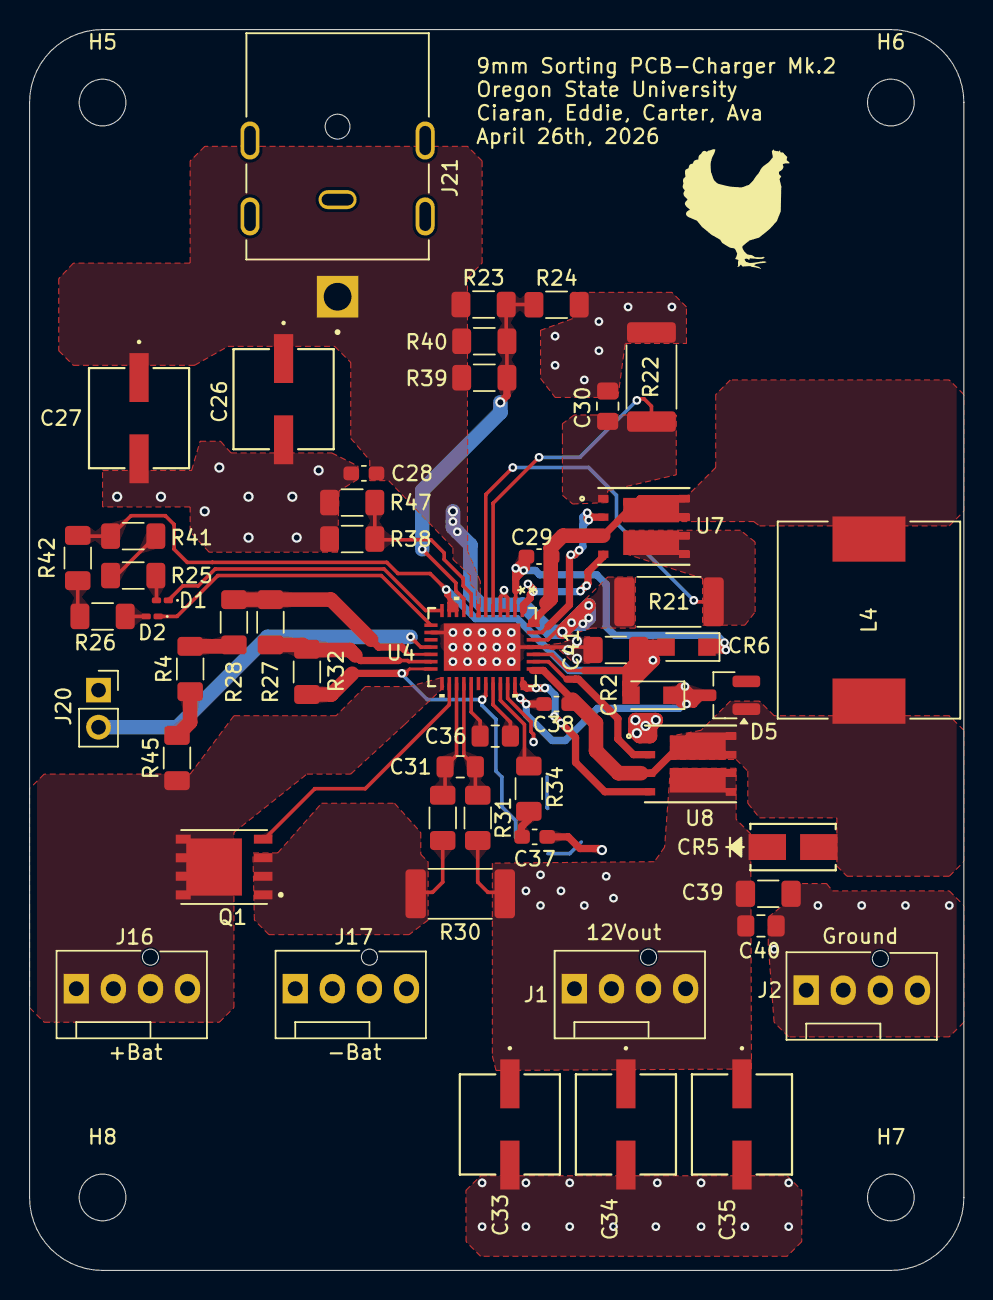
[picture p43: board System PCB-Charging Mk.2.kicad_pcb from above]

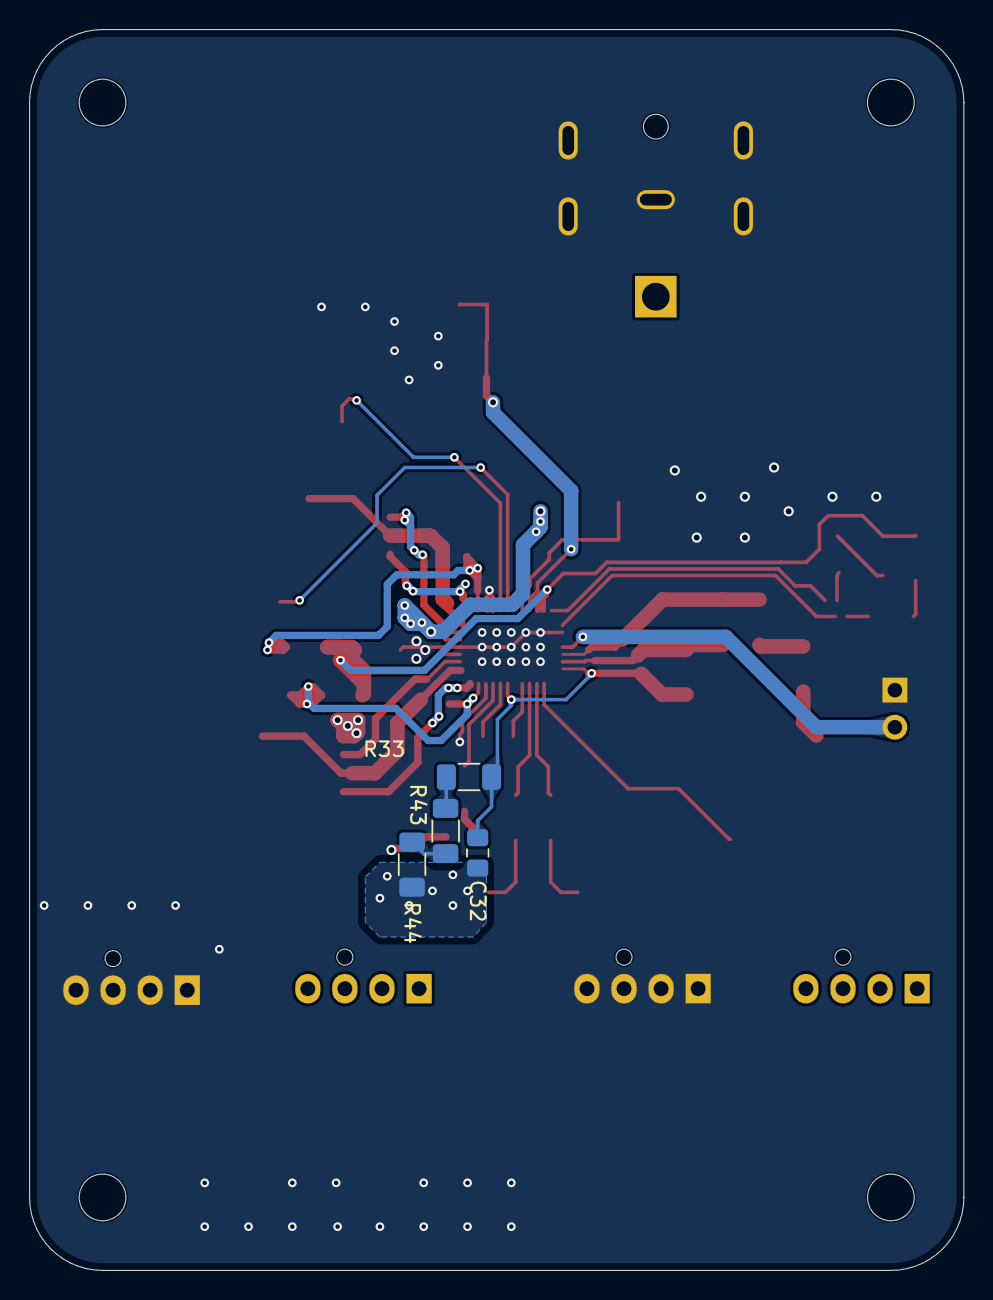
[picture p44: board System PCB-Charging Mk.2.kicad_pcb from below]

Board: 2 copper layers, 64.0 x 85.0 mm, 61 parts (4 on the bottom side), 39 nets.
