eddiemoroz/Automated-9MM-Brass-Headstamp-Sorting-System/PCB Files/System PCB-Bucks Mk.2/System PCB-Bucks Mk.2.kicad_pcb

## KiCad design PCB Files/System PCB-Bucks Mk.2/System PCB-Bucks Mk.2.kicad_pcb (2026-05-16)

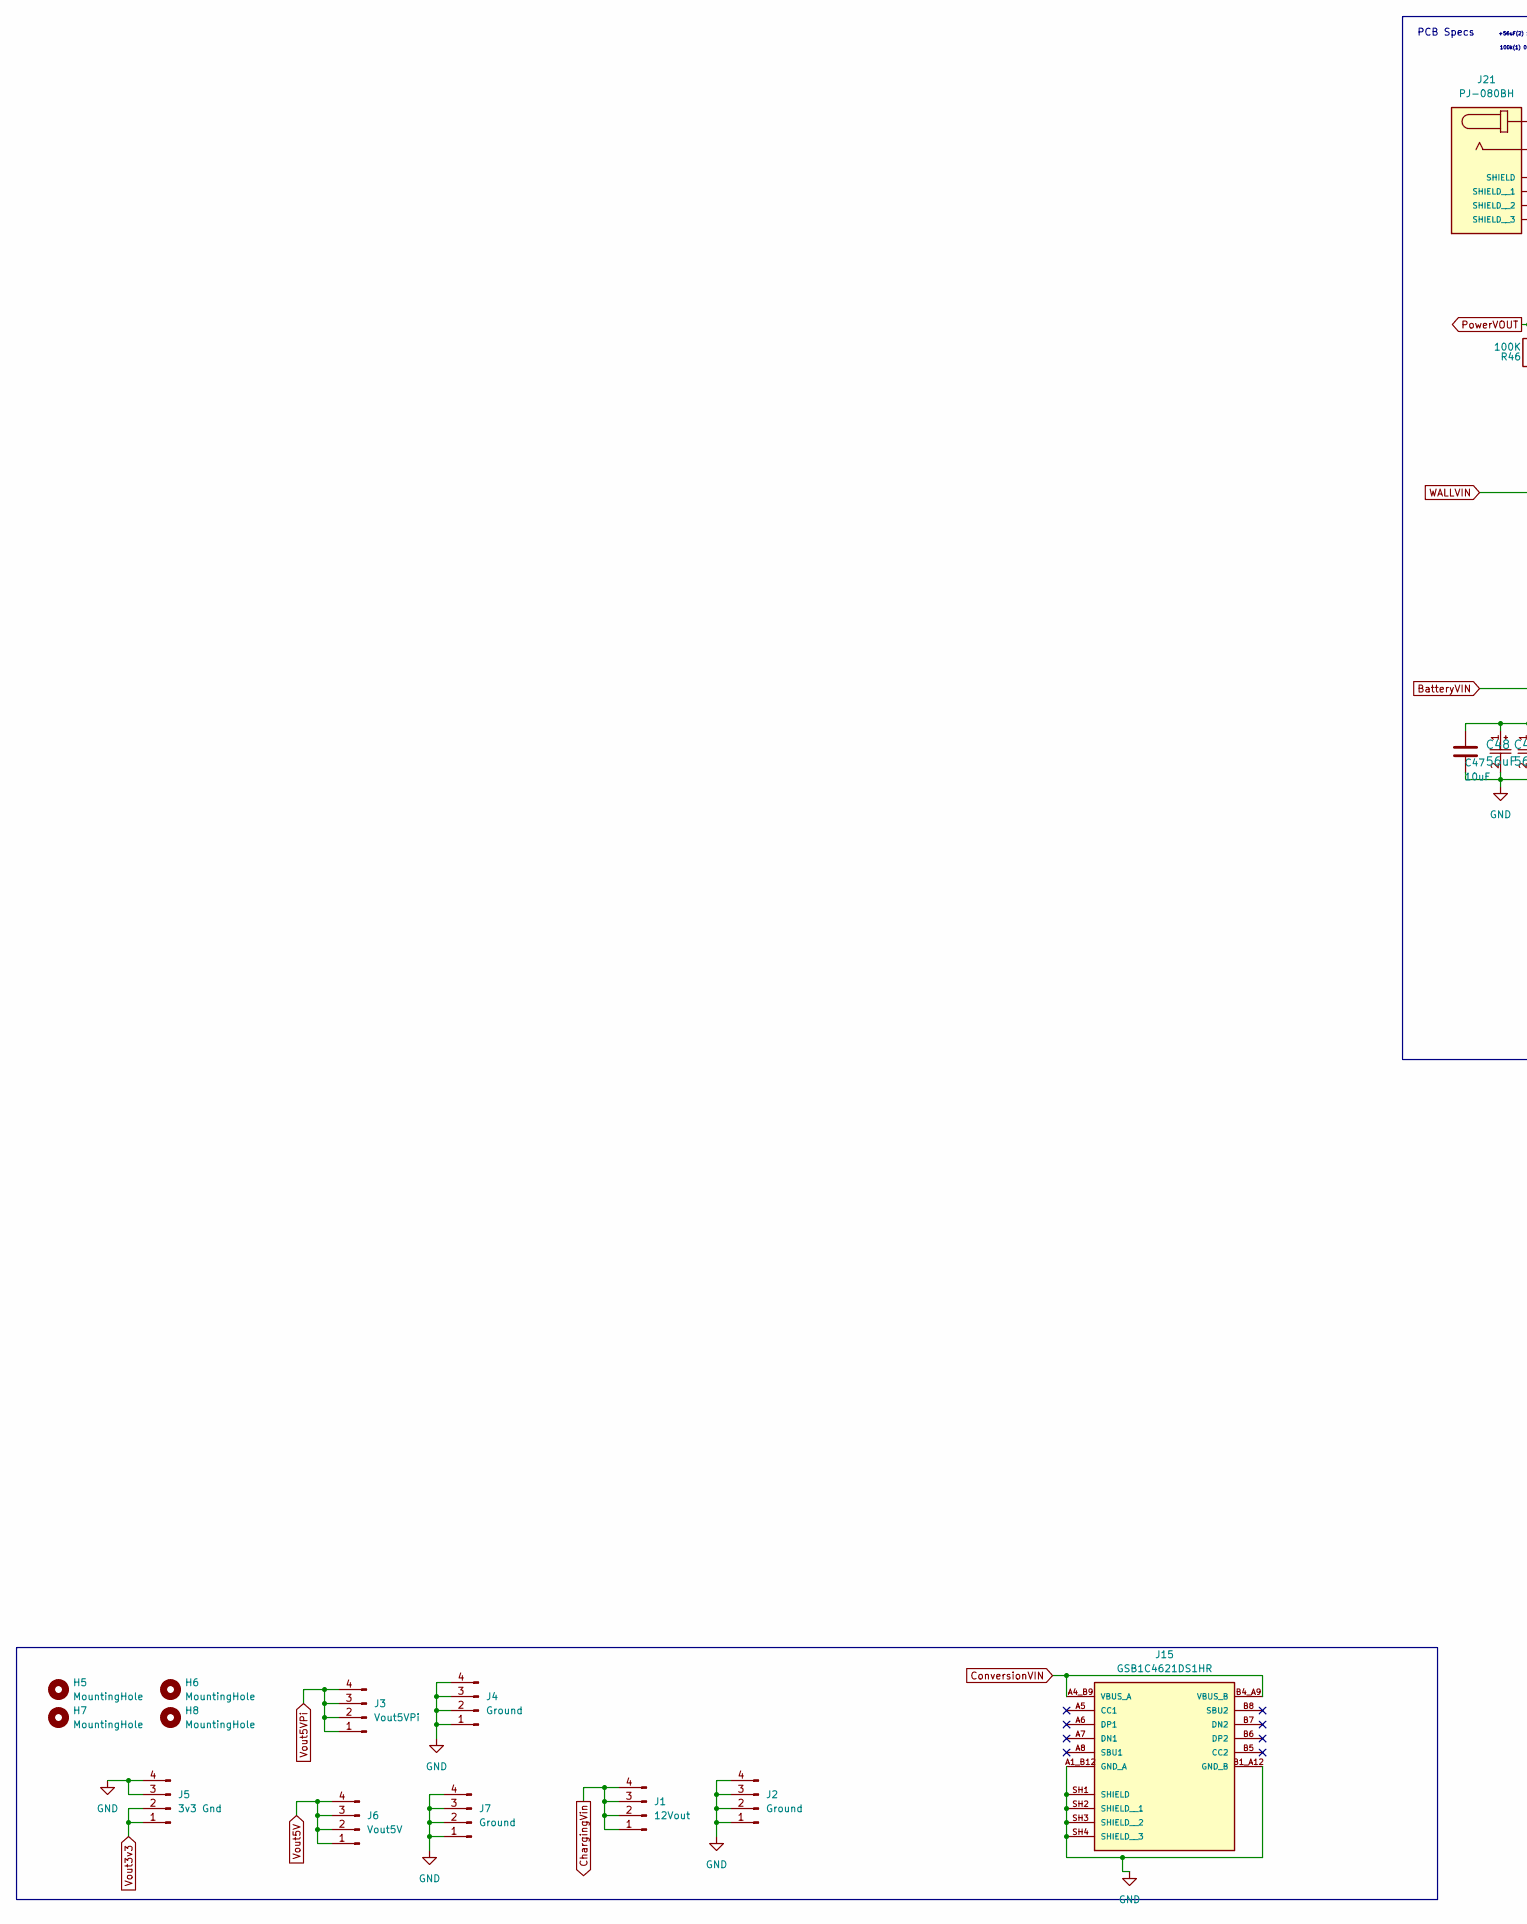
[picture p45: schematic System PCB-Bucks Mk.2.kicad_sch, part in row 1, column 1]

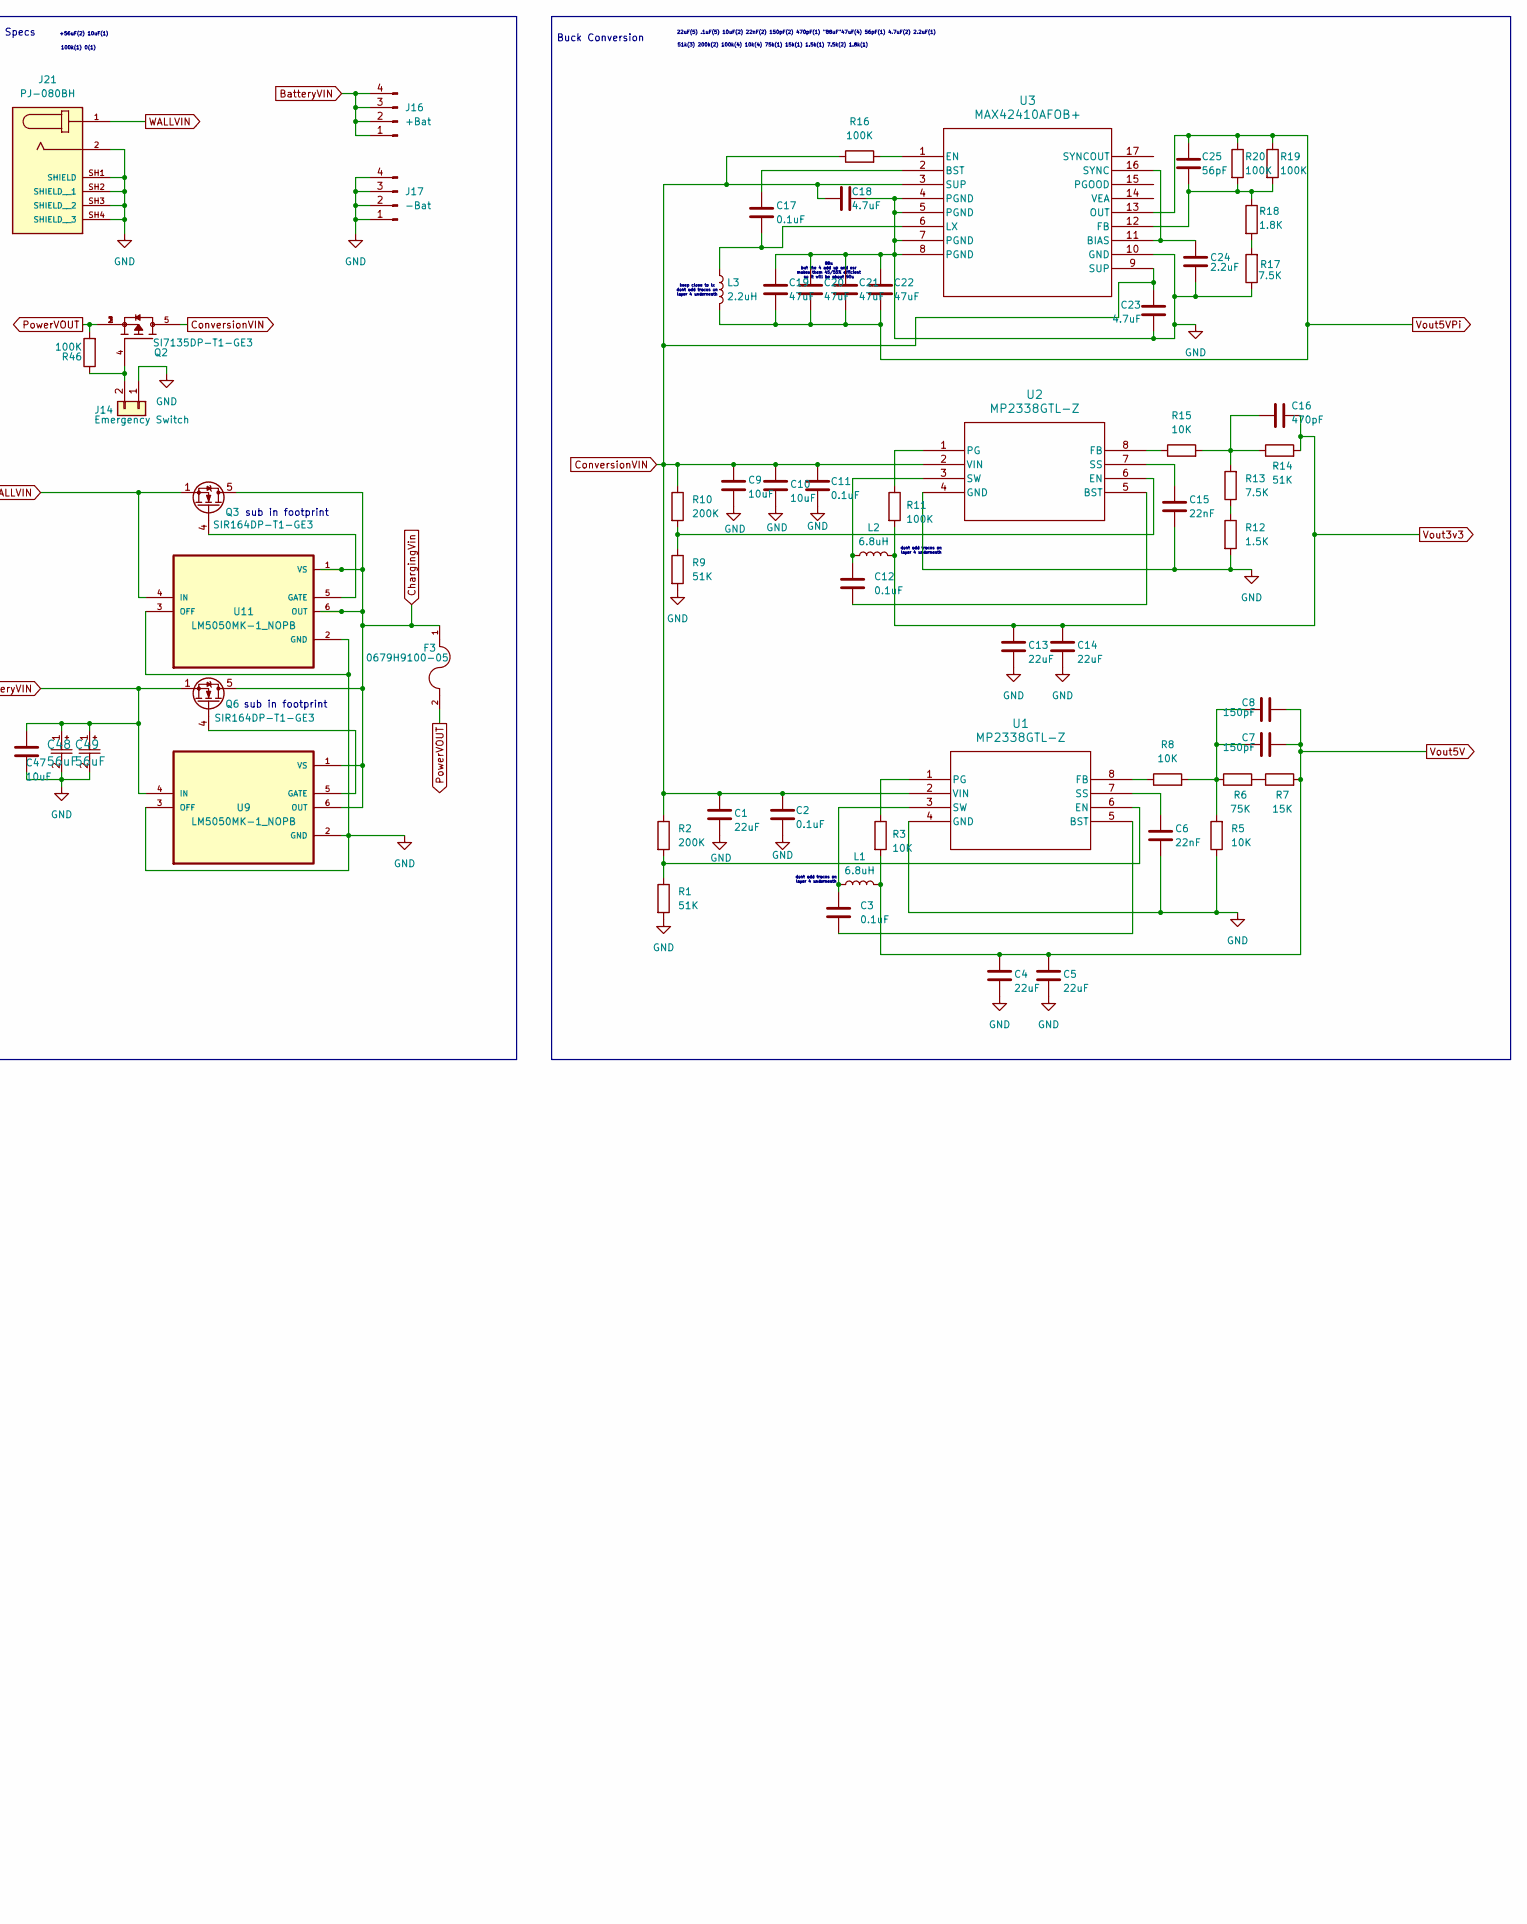
[picture p46: schematic System PCB-Bucks Mk.2.kicad_sch, part in row 1, column 2]

Parts:
C1, C4, C5, C13, C14: 22uF; C_1210_3225Metric_Pad1.33x2.70mm_HandSolder
C2, C3, C11, C12, C17: 0.1uF; C_0805_2012Metric_Pad1.18x1.45mm_HandSolder
C6, C15: 22nF; C_0805_2012Metric_Pad1.18x1.45mm_HandSolder
C7, C8: 150pF; C_0805_2012Metric_Pad1.18x1.45mm_HandSolder
C9, C10, C47: 10uF; C_1206_3216Metric_Pad1.33x1.80mm_HandSolder
C16: 470pF; C_0805_2012Metric_Pad1.18x1.45mm_HandSolder
C18, C23: 4.7uF; C_1206_3216Metric_Pad1.33x1.80mm_HandSolder
C19, C20, C21, C22: 47uF; C_1210_3225Metric_Pad1.33x2.70mm_HandSolder
C24: 2.2uF; C_0805_2012Metric_Pad1.18x1.45mm_HandSolder
C25: 56pF; C_0402_1005Metric_Pad0.74x0.62mm_HandSolder
C48, C49: 56uF; CAP_GY_6P3X5P8_NCH-M
F3: 0679H9100-05; FUSC6125X279N; PARTREV 0679H Apr2019
H5, H6, H7, H8: MountingHole; MountingHole_3.2mm_M3
J1: 12Vout; FanPinHeader_1x04_P2.54mm_Vertical
J2, J4, J7: Ground; FanPinHeader_1x04_P2.54mm_Vertical
J3: Vout5VPi; FanPinHeader_1x04_P2.54mm_Vertical
J5: 3v3 Gnd; FanPinHeader_1x04_P2.54mm_Vertical
J6: Vout5V; FanPinHeader_1x04_P2.54mm_Vertical
J14: Emergency Switch; PinSocket_1x02_P2.54mm_Vertical
J15: GSB1C4621DS1HR; AMPHENOL_GSB1C4621DS1HR; PARTREV AX1
J16: +Bat; FanPinHeader_1x04_P2.54mm_Vertical
J17: -Bat; FanPinHeader_1x04_P2.54mm_Vertical
J21: PJ-080BH; CUI_PJ-080BH; PARTREV 1.04
L1, L2: 6.8uH; IND_8357068_WRE-M
L3: 2.2uH; IND_SRP1265A-2R2M
Q2: SI7135DP-T1-GE3; TRANS_SI7135DP-T1-GE3; PARTREV A
Q3, Q6: SIR164DP-T1-GE3; PowerPAK_SO-8_Single
R1, R9, R14: 51K; R_1206_3216Metric_Pad1.30x1.75mm_HandSolder
R2, R10: 200K; R_1206_3216Metric_Pad1.30x1.75mm_HandSolder
R3, R5, R8, R15: 10K; R_1206_3216Metric_Pad1.30x1.75mm_HandSolder
R6: 75K; R_1206_3216Metric_Pad1.30x1.75mm_HandSolder
R7: 15K; R_1206_3216Metric_Pad1.30x1.75mm_HandSolder
R11, R16, R19, R20, R46: 100K; R_1206_3216Metric_Pad1.30x1.75mm_HandSolder
R12: 1.5K; R_1206_3216Metric_Pad1.30x1.75mm_HandSolder
R13, R17: 7.5K; R_1206_3216Metric_Pad1.30x1.75mm_HandSolder
R18: 1.8K; R_1206_3216Metric_Pad1.30x1.75mm_HandSolder
U1, U2: MP2338GTL-Z; SOT-583-8
U3: MAX42410AFOB+
U9, U11: LM5050MK-1_NOPB; LM5050MK-1NOPB

Connections:
BatteryVIN: C47.1, C48.1, C49.1, J16.1, J16.2, J16.3, J16.4, Q6.1 (S), Q6.2 (S), Q6.3 (S), U9.4 (IN)
ChargingVin: F3.1, J1.1, J1.2, J1.3, J1.4, Q3.5 (D), Q6.5 (D), U9.1 (VS), U9.6 (OUT), U11.1 (VS), U11.6 (OUT)
ConversionVIN: C1.1, C2.1, C9.1, C10.1, C11.1, C18.2, C23.1, J15.A4_B9 (VBUS_A), J15.B4_A9 (VBUS_B), Q2.5, R2.1, R10.1, R16.1, U1.2 (VIN), U2.2 (VIN), U3.3 (SUP), U3.9 (SUP)
GND: C1.2, C2.2, C4.2, C5.2, C6.2, C9.2, C10.2, C11.2, C13.2, C14.2, C15.2, C18.1, C19.1, C20.1, C21.1, C22.1, C23.2, C24.2, C47.2, C48.2, C49.2, J2.1, J2.2, J2.3, J2.4, J4.1, J4.2, J4.3, J4.4, J5.3, J5.4, J7.1, J7.2, J7.3, J7.4, J14.1, J15.A1_B12 (GND_A), J15.B1_A12 (GND_B), J15.SH1 (SHIELD), J15.SH2 (SHIELD__1), J15.SH3 (SHIELD__2), J15.SH4 (SHIELD__3), J17.1, J17.2, J17.3, J17.4, J21.2, J21.SH1 (SHIELD), J21.SH2 (SHIELD__1), J21.SH3 (SHIELD__2), J21.SH4 (SHIELD__3), R1.2, R5.1, R9.2, R12.2, R17.1, U1.4 (GND), U2.4 (GND), U3.4 (PGND), U3.5 (PGND), U3.7 (PGND), U3.8 (PGND), U3.10 (GND), U9.2 (GND), U9.3 (OFF), U11.2 (GND), U11.3 (OFF)
unnamed: C7.1, C8.1, R5.2, R6.1, R8.2
unnamed: C16.1, R13.2, R14.1, R15.2
unnamed: J14.2, Q2.4, R46.1
unnamed: Q3.4 (G), U11.5 (GATE)
unnamed: Q6.4 (G), U9.5 (GATE)
unnamed: R6.2, R7.1
unnamed: R12.1, R13.1
unnamed: R17.2, R18.2
unnamed: C3.1, U1.5 (BST)
unnamed: R1.1, R2.2, U1.6 (EN)
unnamed: R8.1, U1.8 (FB)
unnamed: R3.1, U1.1 (PG)
unnamed: C6.1, U1.7 (SS)
unnamed: C3.2, L1.1, U1.3 (SW)
unnamed: C12.1, U2.5 (BST)
unnamed: R9.1, R10.2, U2.6 (EN)
unnamed: R15.1, U2.8 (FB)
unnamed: R11.1, U2.1 (PG)
unnamed: C15.1, U2.7 (SS)
unnamed: C12.2, L2.1, U2.3 (SW)
unnamed: C24.1, U3.11 (BIAS), U3.16 (SYNC)
unnamed: C17.1, U3.2 (BST)
unnamed: R16.2, U3.1 (EN)
unnamed: C25.2, R18.1, R19.2, R20.2, U3.12 (FB)
unnamed: C17.2, L3.1, U3.6 (LX)
PowerVOUT: F3.2, Q2.1, Q2.2, Q2.3, R46.2
Vout3v3: C13.1, C14.1, C16.2, J5.1, J5.2, L2.2, R11.2, R14.2
Vout5V: C4.1, C5.1, C7.2, C8.2, J6.1, J6.2, J6.3, J6.4, L1.2, R3.2, R7.2
Vout5VPi: C19.2, C20.2, C21.2, C22.2, C25.1, J3.1, J3.2, J3.3, J3.4, L3.2, R19.1, R20.1, U3.13 (OUT)
WALLVIN: J21.1, Q3.1 (S), Q3.2 (S), Q3.3 (S), U11.4 (IN)

Notes on the sheet:
sub in footprint
Buck Conversion
dont add traces on layer 4 underneath
+56uF(2) 10uF(1)
51k(3) 200k(2) 100k(4) 10k(4) 75k(1) 15k(1) 1.5k(1) 7.5k(2) 1.8k(1)
keep close to lx dont add traces on layer 4 underneath
PCB Specs
22uF(5) .1uF(5) 10uF(2) 22nF(2) 150pF(2) 470pF(1) "88uF"47uF(4) 56pF(1) 4.7uF(2) 2.2uF(1)
88u but the 4 add up and esr makes them 45/55% efficient so it will be about 90u
100k(1) 0(1)

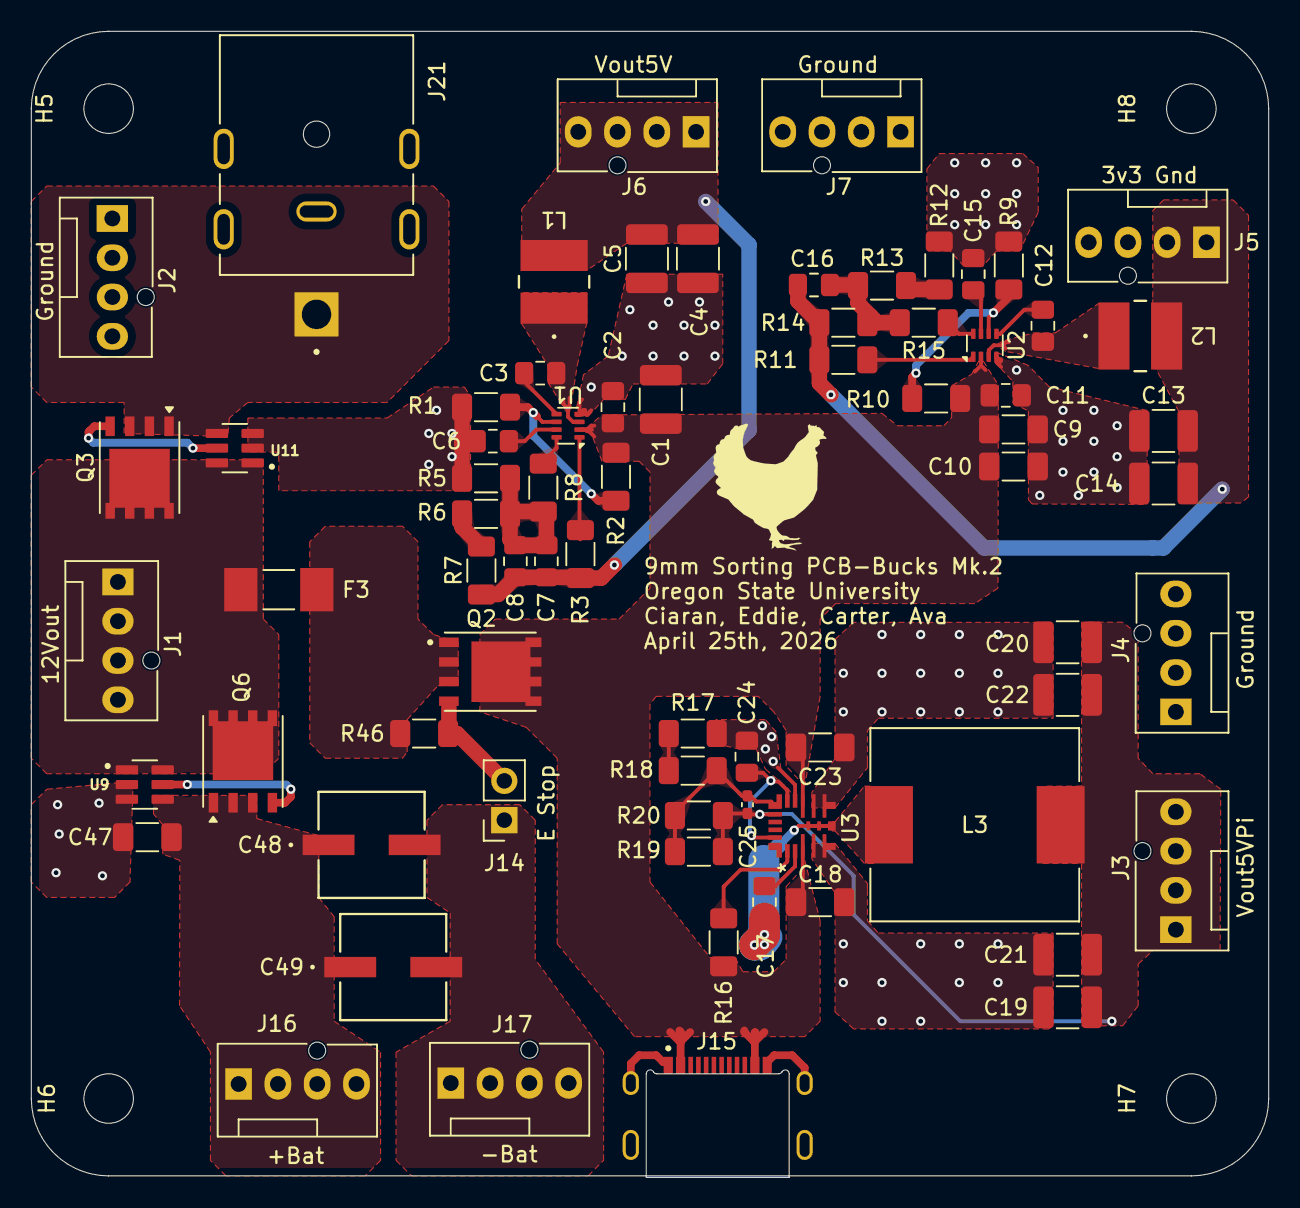
[picture p47: board System PCB-Bucks Mk.2.kicad_pcb from above]

Board: 2 copper layers, 80.0 x 74.0 mm, 76 parts (0 on the bottom side), 34 nets.
