eddiemoroz/Automated-9MM-Brass-Headstamp-Sorting-System/(commit log)

2026-05-16 Artifacts folder + old power PCB
2026-05-16 PCB File Uploads
    Nothing
    [System PCB-Controls Mk.2-B_Cu.gbl, System PCB-Controls Mk.2-B_Mask.gbs, System PCB-Controls Mk.2-B_Paste.gbp, System PCB-Controls Mk.2-B_Silkscreen.gbo, System PCB-Controls Mk.2-Edge_Cuts.gm1, System PCB-Controls Mk.2-F_Cu.gtl, System PCB-Controls Mk.2-F_Mask.gts, System PCB-Controls Mk.2-F_Paste.gtp]
2026-05-16 PCB File Uploads
2026-05-16 Buck PCB
    [System PCB-Bucks Mk.2-B_Cu.gbl, System PCB-Bucks Mk.2-B_Mask.gbs, System PCB-Bucks Mk.2-B_Paste.gbp, System PCB-Bucks Mk.2-B_Silkscreen.gbo, System PCB-Bucks Mk.2-Edge_Cuts.gm1, System PCB-Bucks Mk.2-F_Cu.gtl, System PCB-Bucks Mk.2-F_Mask.gts, System PCB-Bucks Mk.2-F_Paste.gtp]
2026-05-16 Charging PCB
    [System PCB-Charging Mk.2-B_Cu.gbl, System PCB-Charging Mk.2-B_Mask.gbs, System PCB-Charging Mk.2-B_Paste.gbp, System PCB-Charging Mk.2-B_Silkscreen.gbo, System PCB-Charging Mk.2-Edge_Cuts.gm1, System PCB-Charging Mk.2-F_Cu.gtl, System PCB-Charging Mk.2-F_Mask.gts, System PCB-Charging Mk.2-F_Paste.gtp]
2026-05-16 Controls PCB
    [System PCB-Controls Mk.2-B_Cu.gbl, System PCB-Controls Mk.2-B_Mask.gbs, System PCB-Controls Mk.2-B_Paste.gbp, System PCB-Controls Mk.2-B_Silkscreen.gbo, System PCB-Controls Mk.2-Edge_Cuts.gm1, System PCB-Controls Mk.2-F_Cu.gtl, System PCB-Controls Mk.2-F_Mask.gts, System PCB-Controls Mk.2-F_Paste.gtp]
2026-05-16 Added Enclosure .STL files
    [Bin Base L.stl, Bin Base R.stl, Bin1.stl, Bottom Funnel.stl, Bottom Panel L.stl, Bottom Panel R.stl, Camera Face.stl, Camera Holder.stl]
2026-05-16 Added exported Fusion design
    [Enclosure.f3z]
2026-05-16 Added Python Code files
    - Includes headstampSorting folder that goes onto the Raspberry Pi 5 and serves as the primary folder
    - Includes training script for model, image processing, and generating datasets
